DominikRzecki/mpm-hardware/README.md

# mpm-hardware
Mobile power measurement. Hardware repo
Update
