DominikRzecki/mpm-hardware/breakout-board-power-measurement/component-list.txt

Shunts 11x:
Einer davon:
	https://www.mouser.at/c/passive-components/resistors/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
z.B:
	https://www.mouser.at/ProductDetail/SEI-Stackpole/CSNL1206FT10L0?qs=IPgv5n7u5QaI49TqMum75g%3D%3D
	
oder:
	https://www.distrelec.at/de/shunt-10mohm-metallschicht-1w-ohmite-fc4l32r010fer/p/30229675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
oder:
	https://at.rs-online.com/web/p/smd-widerstande/1260359
	
Spulen: 11x
	https://at.rs-online.com/web/p/smd-induktivitat/1675875
oder:
	https://at.rs-online.com/web/p/smd-induktivitat/7474751
	
Oszillator 2x:
	https://at.rs-online.com/web/p/schwingquarz/6938803
	
Kondensator 5x:
	https://at.rs-online.com/web/p/keramik-vielschichtkondensatoren/1466584
