DominikRzecki/mpm-hardware/mechanik_3d/Files_for_print/deckel_main_v2.stl

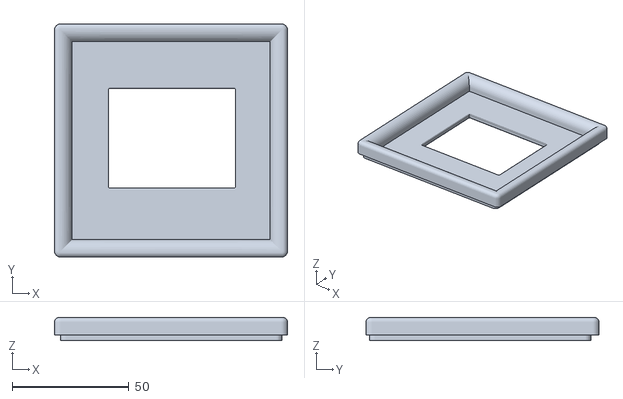
[picture p1: CAD file, 2023-05-02]
mechanik_3d/Files_for_print/deckel_main_v2.stl
100.0 x 100.0 x 10.00
