DominikRzecki/mpm-hardware/mechanik_3d/Files_for_print/main_box_v3.stl

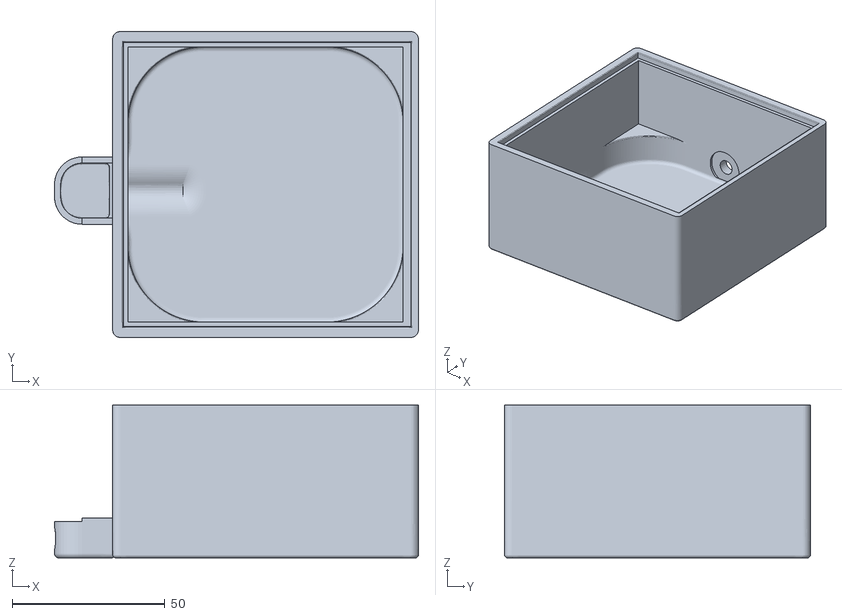
[picture p2: CAD file, 2023-05-02]
mechanik_3d/Files_for_print/main_box_v3.stl
119.0 x 100.0 x 50.0
