DominikRzecki/mpm-hardware/mechanik_3d/Files_for_print/deckel_v2.stl

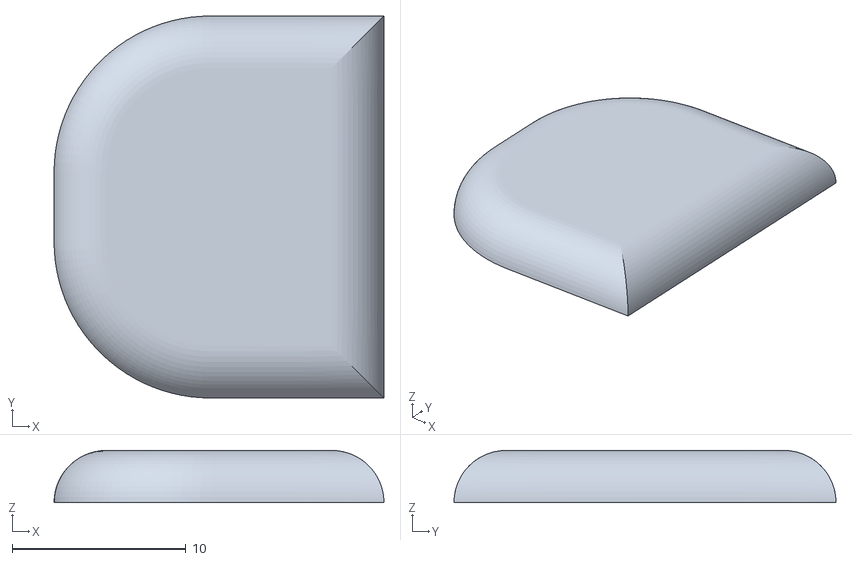
[picture p3: CAD file, 2023-05-02]
mechanik_3d/Files_for_print/deckel_v2.stl
19.0 x 22.0 x 3.00
