DominikRzecki/mpm-hardware/(list of files, cad)

Other CAD files:
mechanik_3d/Files_for_print/main_box_v2.stl
mechanik_3d/MPM_pwm v19.f3d
mechanik_3d/MPM_pwm v7.f3d
