DominikRzecki/mpm-hardware/breakout-board-power-measurement/power_measurement_fraesen/project/breakout-board-power-measurement.pdf

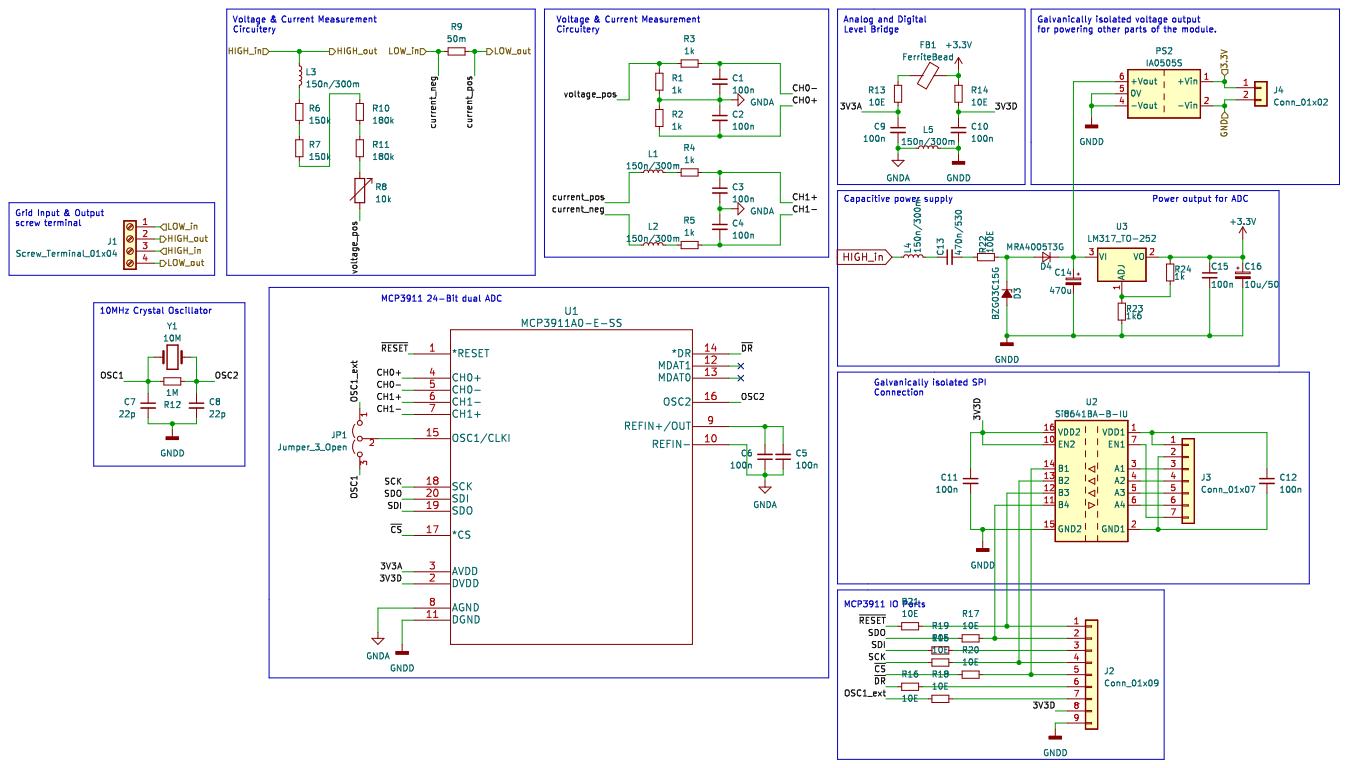
[picture p4: page 1]
