DominikRzecki/mpm-hardware/breakout-board-power-measurement/ltspice/capacitive-power-supply-3.asc

C1: cap; 25µ
C2: cap; 470µ
C3: cap; 10n
C4: cap; 100n
C5: cap; 470µ
D1: zener; 1N4469
D2: schottky; UPSC600
D4: diode
D5: diode
D6: diode
D7: diode
L1: ind; 10µH
R1: res; 100
R2: res; 1k6
R3: res; 1k
R4: res; 3
U1: LM317
V1: voltage; SINE(0 {230*sqrt(2)} 50)
Named nets: 0, ue, ua, ux
.tran 0 30ms 0 .001 uic
Am LM317 fällt sehr viel Leistung ab
 -> Buck könnte besser
