DominikRzecki/mpm-hardware/breakout-board-power-measurement/ltspice/capacitive-power-supply-2.asc

C1: cap; 820n
C2: cap; 470µ
C3: cap; 10n
C4: cap; 100n
C5: cap; 470µ
D1: zener; BZX84C15L
D2: schottky; UPSC600
R1: res; 100
R2: res; 1k6
R3: res; 1k
R4: res; 165
U1: LM317
V1: voltage; SINE(0 {230*sqrt(2)} 50)
Named nets: 0, ue, ua, ux
.tran 0 2 1.92 .001 uic
Am LM317 fällt sehr viel Leistung ab
 -> Buck könnte besser
