DominikRzecki/mpm-hardware/breakout-board-power-measurement/ltspice/Draft2.asc

C1: cap; 100n
L1: FerriteBead; 3.42µ; Ipk=0.2 Rser=0.6 Rpar=2780 Cpar=970f mfg="Würth Elektronik" pn="742792093 WE-CBF 0805"
R1: res; 165
V1: voltage; 3.3
V2: voltage; PULSE(0 .001 0 10n 10n 50n 100n)
Named nets: 0
.tran 0 .5 0 .000001
