DominikRzecki/mpm-hardware/breakout-board-power-measurement/ltspice/capacitive-power-supply.asc

C1: cap; 470µ
C2: cap; 820µ
C3: cap; 10n
C4: cap; 100n
C5: cap; 470µ
C6: cap; 470µ
C7: cap; 820µ
C8: cap; 10n
C9: cap; 100n
C10: cap; 470µ
C11: cap; 10nF
C12: cap; 22µF
C13: cap; 0.1µF
C14: cap; 10pF
C15: cap; 1µF
D1: zener; 1N4471
D2: schottky; UPSC600
D3: zener; 1N4471
D4: schottky; UPSC600
L1: ind; 2.2µH
R1: res; 100
R2: res; 1k6
R3: res; 1k
R5: res; 100
R6: res; 4.7
R7: res; 309k
R8: res; 1Meg
R9: res; 18.2k
R10: res; 100k
Rl: res; 4.7
U1: LM317
U2: LT8607
V1: voltage; SINE(0 {230*sqrt(2)} 50)
V2: voltage; SINE(0 {230*sqrt(2)} 50)
Named nets: 0, ue, ua, ux, ue1, ux1, ua1
.tran 0 40 0 1 uic
Am LM317 fällt sehr viel Leistung ab
 -> Buck könnte besser
Mit Buck
