DominikRzecki/mpm-hardware/power-measurement-final/power-measurement-final/power-measurement-final.kicad_pcb

## KiCad design power-measurement-final/power-measurement-final/power-measurement-final.kicad_pcb (2023-05-12)

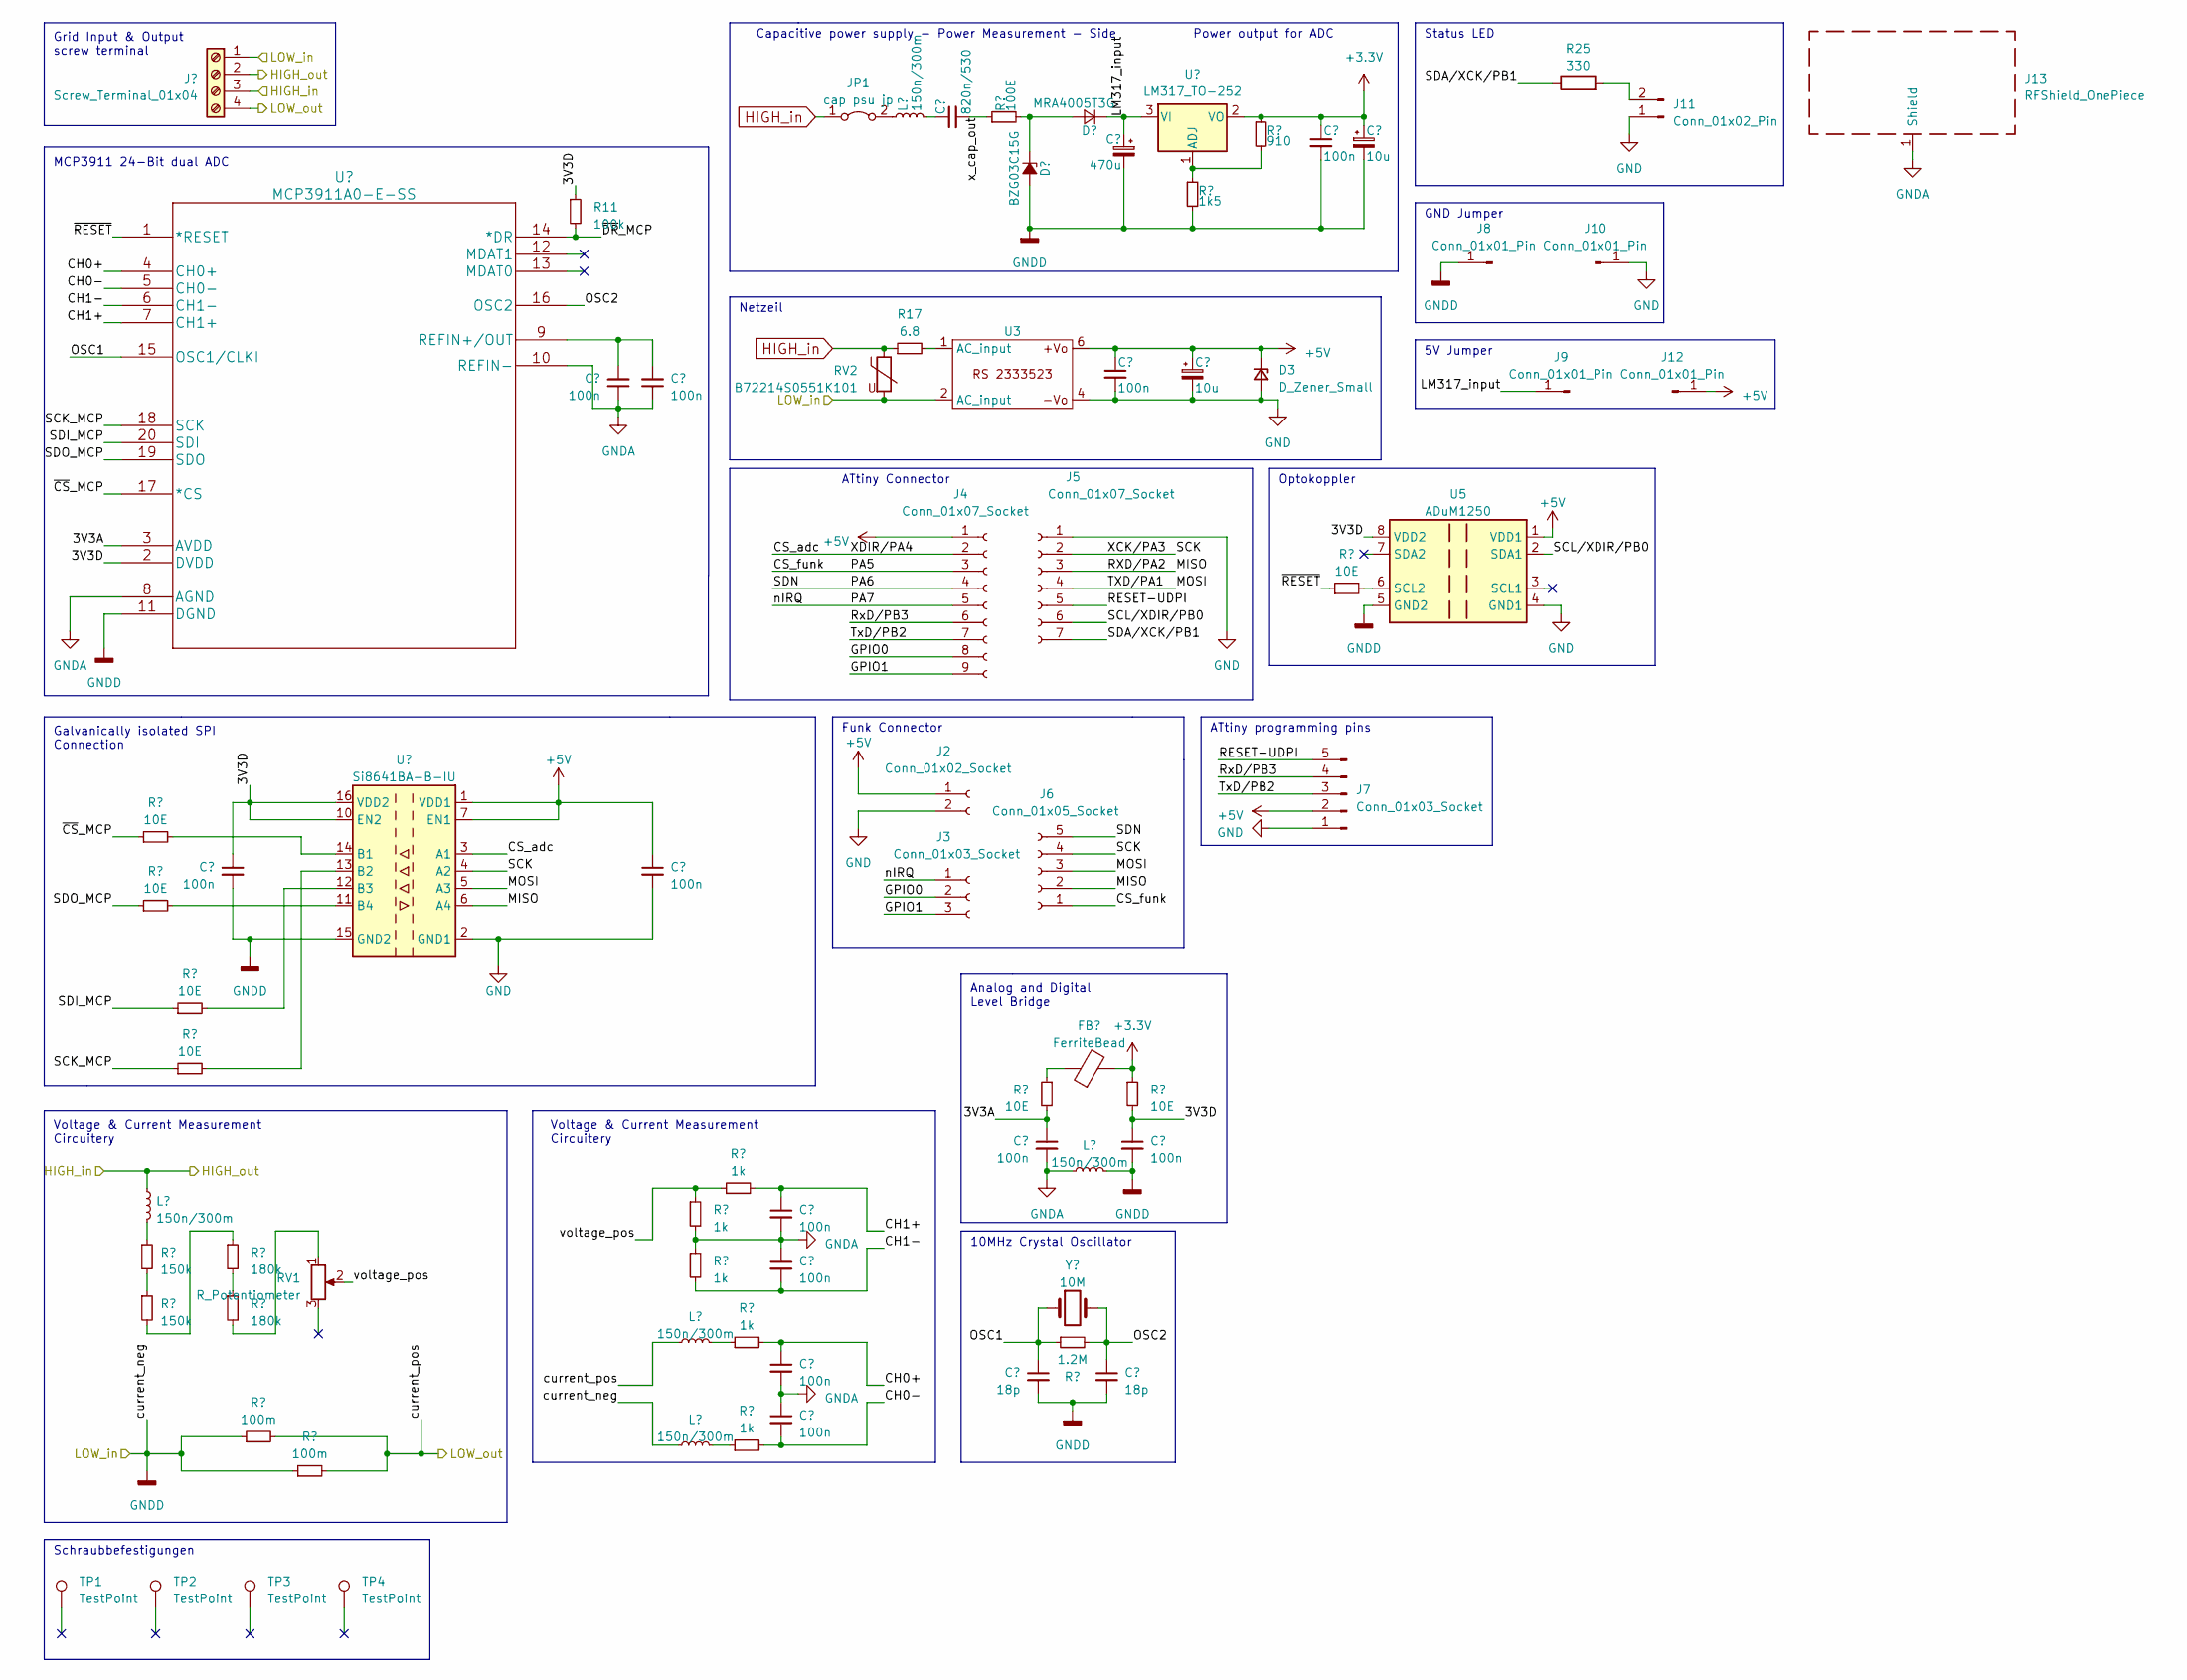
[picture p5: schematic power-measurement-final.kicad_sch]

Parts:
C1, C2, C3, C4, C5, C6, C7, C8, C11, C13, C15, C17: 100n; C_1206_3216Metric_Pad1.33x1.80mm_HandSolder
C9: 820n/530; C_Rect_L26.5mm_W10.5mm_P22.50mm_MKS4
C10, C12: 18p; C_0805_2012Metric_Pad1.18x1.45mm_HandSolder
C14: 470u; CP_Radial_D10.0mm_P5.00mm
C16, C18: 10u; C_1206_3216Metric_Pad1.33x1.80mm_HandSolder
D1: BZG03C15G; D_SMA-SMB_Universal_Handsoldering
D2: MRA4005T3G; D_MicroMELF_Handsoldering
D3: D_Zener_Small; D_1206_3216Metric_Pad1.42x1.75mm_HandSolder
FB1: FerriteBead; L_1210_3225Metric_Pad1.42x2.65mm_HandSolder
J1: Screw_Terminal_01x04; PhoenixContact_MSTBVA_2,5_4-G-5,08_1x04_P5.08mm_Vertical
J2: Conn_01x02_Socket; PinSocket_1x02_P2.54mm_Vertical
J3: Conn_01x03_Socket; PinSocket_1x03_P2.54mm_Vertical
J4: Conn_01x07_Socket; PinSocket_1x09_P2.54mm_Vertical
J5: Conn_01x07_Socket; PinSocket_1x07_P2.54mm_Vertical
J6: Conn_01x05_Socket; PinSocket_1x05_P2.54mm_Vertical
J7: Conn_01x03_Socket; PinHeader_1x05_P2.54mm_Vertical
J8, J9, J10, J12: Conn_01x01_Pin; PinHeader_1x01_P2.54mm_Vertical
J11: Conn_01x02_Pin; PinHeader_1x02_P2.54mm_Vertical
J13: RFShield_OnePiece; Laird_Technologies_BMI-S-209-F_29.36x18.50mm
JP1: cap psu jp; PinHeader_1x02_P2.54mm_Vertical
L1, L2, L3, L4, L5: 150n/300m; L_1206_3216Metric
R1, R2: 150k; R_1206_3216Metric_Pad1.30x1.75mm_HandSolder
R3, R4, R5, R6, R19, R21, R24: 10E; R_0805_2012Metric_Pad1.20x1.40mm_HandSolder
R7, R8: 180k; R_1206_3216Metric_Pad1.30x1.75mm_HandSolder
R9, R10: 100m; R_2512_6332Metric
R11: 100k; R_1206_3216Metric
R12, R13, R14, R15, R16: 1k; R_1206_3216Metric_Pad1.30x1.75mm_HandSolder
R17: 6.8; R_Radial_Power_L12.0mm_W8.0mm_P5.00mm
R18: 100E; R_1206_3216Metric_Pad1.30x1.75mm_HandSolder
R20: 1.2M; R_1206_3216Metric_Pad1.30x1.75mm_HandSolder
R22: 1k5; R_1206_3216Metric_Pad1.30x1.75mm_HandSolder
R23: 910; R_1206_3216Metric_Pad1.30x1.75mm_HandSolder
R25: 330; R_1206_3216Metric_Pad1.30x1.75mm_HandSolder
RV1: R_Potentiometer; Potentiometer_ACP_CA9-V10_Vertical_Hole
RV2: B72214S0551K101; R_Axial_DIN0204_L3.6mm_D1.6mm_P7.62mm_Horizontal
TP1, TP2, TP3, TP4: TestPoint; TestPoint_Plated_Hole_D3.0mm
U1: MCP3911A0-E-SS; SSOP-20_5.3x7.2mm_P0.65mm
U2: Si8641BA-B-IU; SOIC-16_3.9x9.9mm_P1.27mm
U3: RS_2333523
U4: LM317_TO-252; TO-252-2
U5: ADuM1250; SO-8_5.3x6.2mm_P1.27mm
Y1: 10M; Crystal_HC49-4H_Vertical

Connections:
+3.3V: C17.1, C18.1, FB1.2, R21.1, R23.1, U4.2 (VO)
+5V: C4.1, C13.1, C16.1, D3.1 (K), J2.1, J4.1, J7.2, J12.1, U2.1 (VDD1), U2.7 (EN1), U3.6, U5.1 (VDD1)
/3V3A: C11.1, R19.2, U1.3 (AVDD)
/3V3D: C1.1, C15.1, R11.1, R21.2, U1.2 (DVDD), U2.10 (EN2), U2.16 (VDD2), U5.8 (VDD2)
/CH0+: C7.1, R15.2, U1.4 (CH0+)
/CH0-: C8.2, R16.2, U1.5 (CH0-)
/CH1+: C5.1, R14.2, U1.7 (CH1+)
/CH1-: C6.2, R13.2, U1.6 (CH1-)
/CS_adc: J4.2, U2.3 (A1)
/CS_funk: J4.3, J6.1
/GPIO0: J3.2, J4.8
/GPIO1: J3.3, J4.9
/LM317_input: C14.1, D2.1 (K), J9.1, U4.3 (VI)
/MISO: J5.3, J6.2, U2.6 (A4)
/MOSI: J5.4, J6.3, U2.5 (A3)
/OSC1: C10.1, R20.1, U1.15 (OSC1/CLKI), Y1.1
/OSC2: C12.1, R20.2, U1.16 (OSC2), Y1.2
/PA6: J4.4, J6.5
/PA7: J3.1, J4.5
/RESET-UDPI: J5.5, J7.5
/RxD/PB3: J4.6, J7.4
/SCK: J5.2, J6.4, U2.4 (A2)
/SCK_MCP: R6.1, U1.18 (SCK)
/SCL/XDIR/PB0: J5.6, U5.2 (SDA1)
/SDA/XCK/PB1: J5.7, R25.1
/SDI_MCP: R5.1, U1.20 (SDI)
/SDO_MCP: R4.1, U1.19 (SDO)
/TxD/PB2: J4.7, J7.3
/current_pos: J1.4, L2.1, R9.2, R10.2
/voltage_pos: R12.1, R14.1, RV1.2
/x_cap_out: C9.2, R18.1
/~CS_MCP: R3.1, U1.17 (*CS)
/~DR_MCP: R11.2, U1.14 (*DR)
/~RESET: R24.1, U1.1 (*RESET)
GND: C4.2, C13.2, C16.2, D3.2 (A), J2.2, J5.1, J7.1, J10.1, J11.1, U2.2 (GND1), U2.8 (GND1), U3.4, U5.4 (GND1)
GNDA: C2.1, C3.1, C5.2, C6.1, C7.2, C8.1, C11.2, J13.1 (Shield), L5.1, R12.2, R13.1, U1.8 (AGND), U1.10 (REFIN-)
GNDD: C1.2, C10.2, C12.2, C14.2, C15.2, C17.2, C18.2, D1.2 (A), J1.1, J8.1, L3.1, L5.2, R9.1, R10.1, R22.2, RV2.2, U1.11 (DGND), U2.9 (GND2), U2.15 (GND2), U3.2 (AC_input), U5.5 (GND2)
HIGH_in: J1.2, J1.3, JP1.1 (A), L1.1, R17.1, RV2.1
unnamed: C9.1, L4.2
unnamed: D1.1 (K), D2.2 (A), R18.2
unnamed: FB1.1, R19.1
unnamed: J11.2, R25.2
unnamed: JP1.2 (B), L4.1
unnamed: L1.2, R1.1
unnamed: L2.2, R15.1
unnamed: L3.2, R16.1
unnamed: R1.2, R2.1
unnamed: R2.2, R7.1
unnamed: R7.2, R8.1
unnamed: R8.2, RV1.1
unnamed: R17.2, U3.1 (AC_input)
unnamed: C2.2, C3.2, U1.9 (REFIN+/OUT)
unnamed: R3.2, U2.14 (B1)
unnamed: R6.2, U2.13 (B2)
unnamed: R5.2, U2.12 (B3)
unnamed: R4.2, U2.11 (B4)
unnamed: R22.1, R23.2, U4.1 (ADJ)
unnamed: R24.2, U5.6 (SCL2)

Notes on the sheet:
Netzeil
Voltage & Current Measurement Circuitery
10MHz Crystal Oscillator
Funk Connector
Status LED
ATtiny Connector
Optokoppler
MCP3911 24-Bit dual ADC
5V Jumper
Capacitive power supply - Power Measurement - Side
Power output for ADC
ATtiny programming pins
Schraubbefestigungen
GND Jumper
Galvanically isolated SPI Connection
Grid Input & Output screw terminal
Analog and Digital Level Bridge

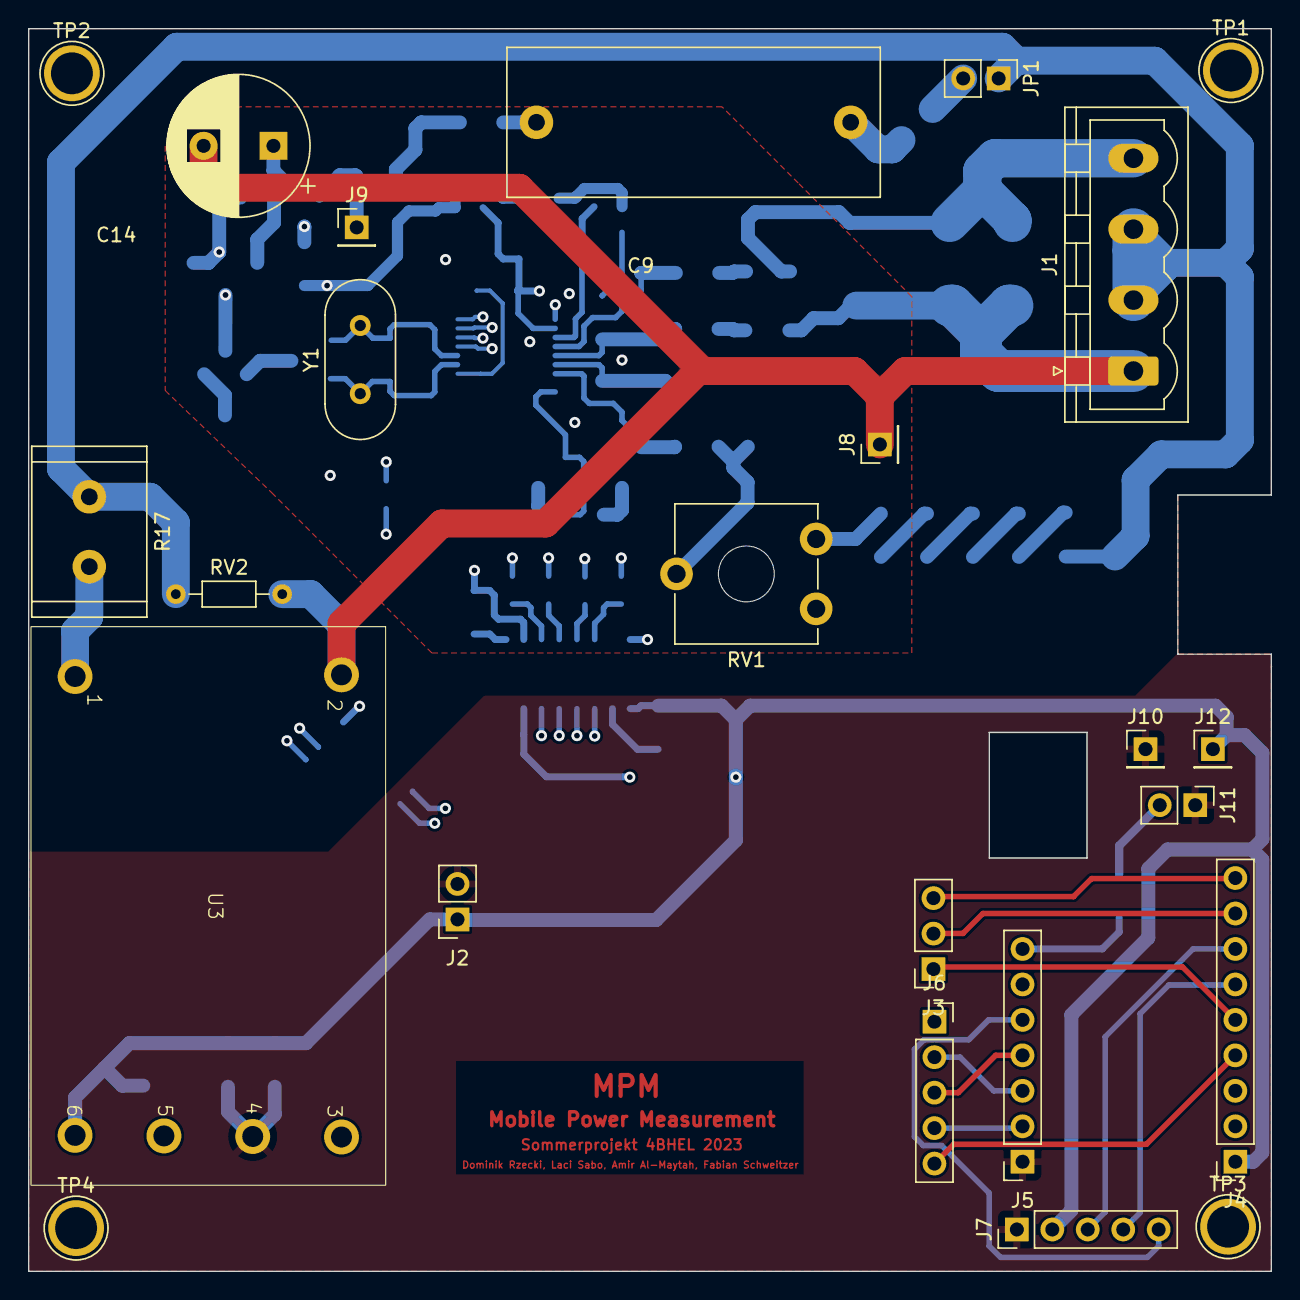
[picture p6: board power-measurement-final.kicad_pcb from above]

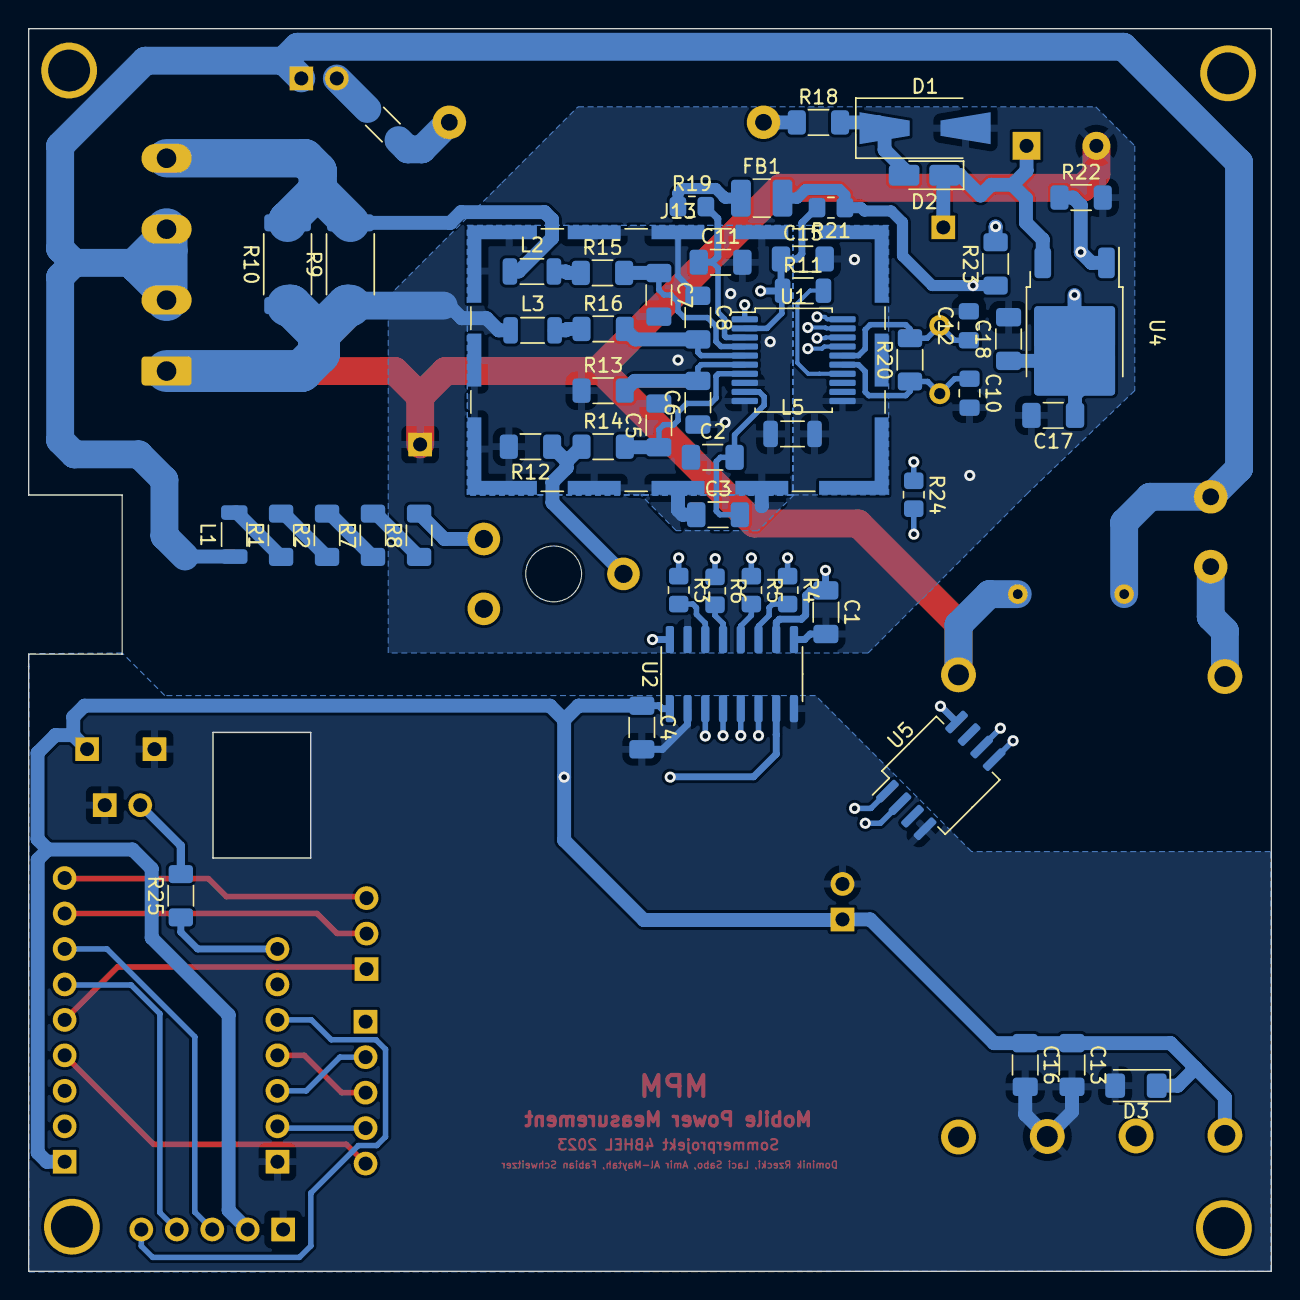
[picture p7: board power-measurement-final.kicad_pcb from below]

Board: 4 copper layers, 89.0 x 89.0 mm, 78 parts (54 on the bottom side), 58 nets.
