DominikRzecki/mpm-hardware/breakout-power-supply/breakout-power-supply.kicad_pcb

## KiCad design breakout-power-supply/breakout-power-supply.kicad_pcb (2023-05-08)

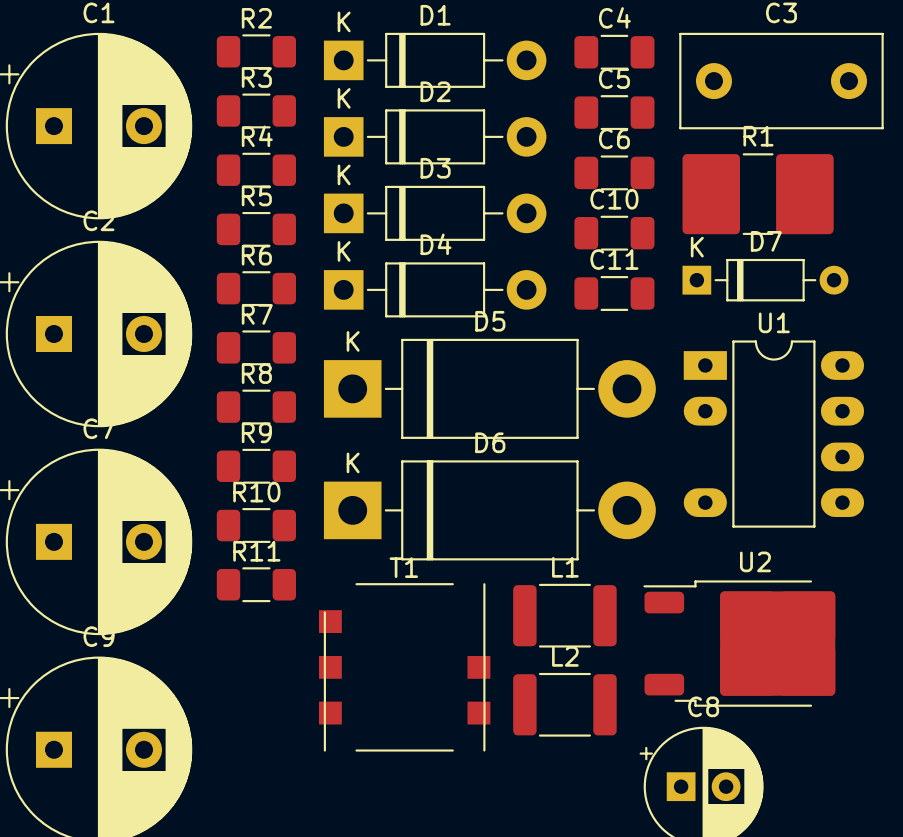
[picture p8: board breakout-power-supply.kicad_pcb from above]

Board: 2 copper layers, 34 parts (0 on the bottom side), 20 nets, no tracks yet.

Parts:
C1, C2: 6u8; CP_Radial_D10.0mm_P5.00mm
C3: 1n; C_Disc_D11.0mm_W5.0mm_P7.50mm
C4, C5, C6: 1u; C_1206_3216Metric_Pad1.33x1.80mm_HandSolder
C7: 1000u; CP_Radial_D10.0mm_P5.00mm
C8: 470u; CP_Radial_D6.3mm_P2.50mm
C9: 470u; CP_Radial_D10.0mm_P5.00mm
C10: 100n; C_1206_3216Metric_Pad1.33x1.80mm_HandSolder
C11: 10u; C_1206_3216Metric_Pad1.33x1.80mm_HandSolder
D1, D2, D3, D4: 1N4007; D_DO-41_SOD81_P10.16mm_Horizontal
D5: D; D_DO-201AD_P15.24mm_Horizontal
D6: 1N5822; D_DO-201AD_P15.24mm_Horizontal
D7: 1N4148; D_DO-35_SOD27_P7.62mm_Horizontal
L1, L2: 1m; L_1812_4532Metric_Pad1.30x3.40mm_HandSolder
R1: 10E; R_2816_7142Metric_Pad3.20x4.45mm_HandSolder
R2: 270k; R_1206_3216Metric_Pad1.30x1.75mm_HandSolder
R3: 330E; R_1206_3216Metric_Pad1.30x1.75mm_HandSolder
R4, R8: 28.7k; R_1206_3216Metric_Pad1.30x1.75mm_HandSolder
R5: 4.42k; R_1206_3216Metric_Pad1.30x1.75mm_HandSolder
R6, R7: 12E; R_1206_3216Metric_Pad1.30x1.75mm_HandSolder
R9: 820E; R_1206_3216Metric_Pad1.30x1.75mm_HandSolder
R10: 1k5; R_1206_3216Metric_Pad1.30x1.75mm_HandSolder
R11: 910; R_1206_3216Metric_Pad1.30x1.75mm_HandSolder
T1: PA0510NL; Pulse_PA2002NL-PA2008NL-PA2009NL
U1: LNK625PG; PowerIntegrations_PDIP-8C
U2: LM317_TO-252; TO-252-2

Connections:
+3.3V: C10.1, C11.1, R11.1, U2.2 (VO)
/5V: C8.1, C9.1, L2.2, R9.2, U2.3 (VI)
/HIGH_in: D1.2 (A), D2.1 (K)
GND: C5.2, C7.2, C8.2, C9.2, C10.2, C11.2, D6.2 (A), R9.1, R10.2
unnamed: C2.2, C4.2, C6.2, L1.2, R5.1, T1.5, U1.5 (S), U1.6 (S), U1.7 (S), U1.8 (S)
unnamed: C3.2, R2.1, R3.2
unnamed: C5.1, R6.1
unnamed: C7.1, L2.1, T1.3
unnamed: C1.1, C2.1, C3.1, D1.1 (K), D3.1 (K), R2.2, T1.1
unnamed: C1.2, D2.2 (A), D4.2 (A), L1.1
unnamed: D3.2 (A), D4.1 (K), R1.2
unnamed: D5.2 (A), U1.4 (D)
unnamed: D5.1 (K), R3.1
unnamed: D6.1 (K), R6.2, T1.6
unnamed: D7.2 (A), R7.1
unnamed: C6.1, D7.1 (K), R8.2
unnamed: R4.2, R7.2, T1.4
unnamed: C4.1, R8.1, U1.2 (BP)
unnamed: R4.1, R5.2, U1.1 (FB)
unnamed: R10.1, R11.2, U2.1 (ADJ)
