DominikRzecki/mpm-hardware/funk-final/funk-transmitter-final/funk-transmitter-final.kicad_pcb

## KiCad design funk-final/funk-transmitter-final/funk-transmitter-final.kicad_pcb (2023-04-25)

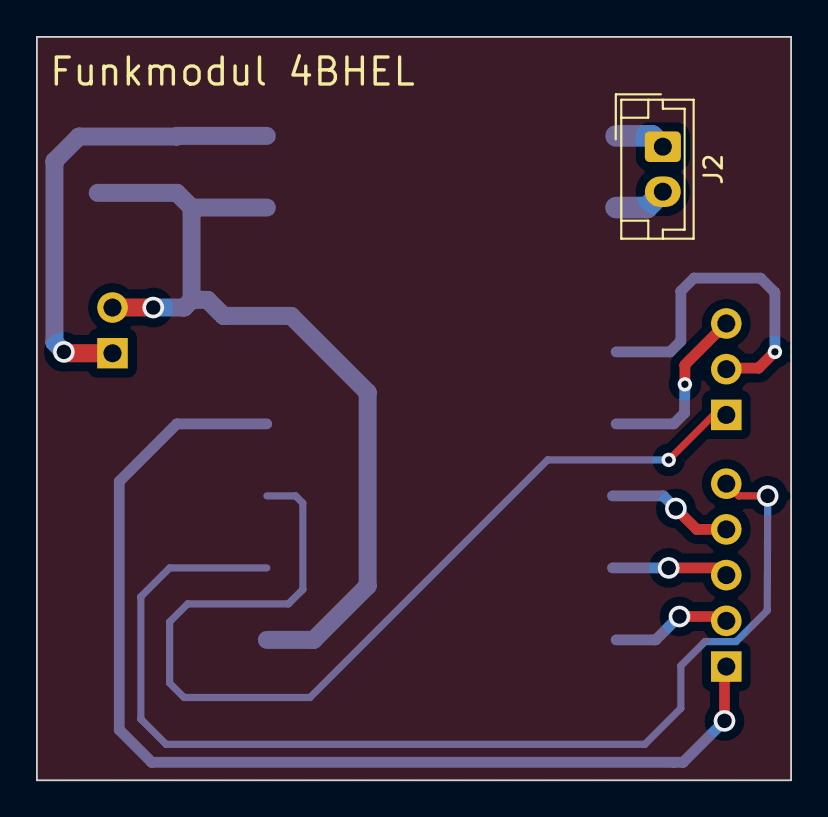
[picture p9: board funk-transmitter-final.kicad_pcb from above]

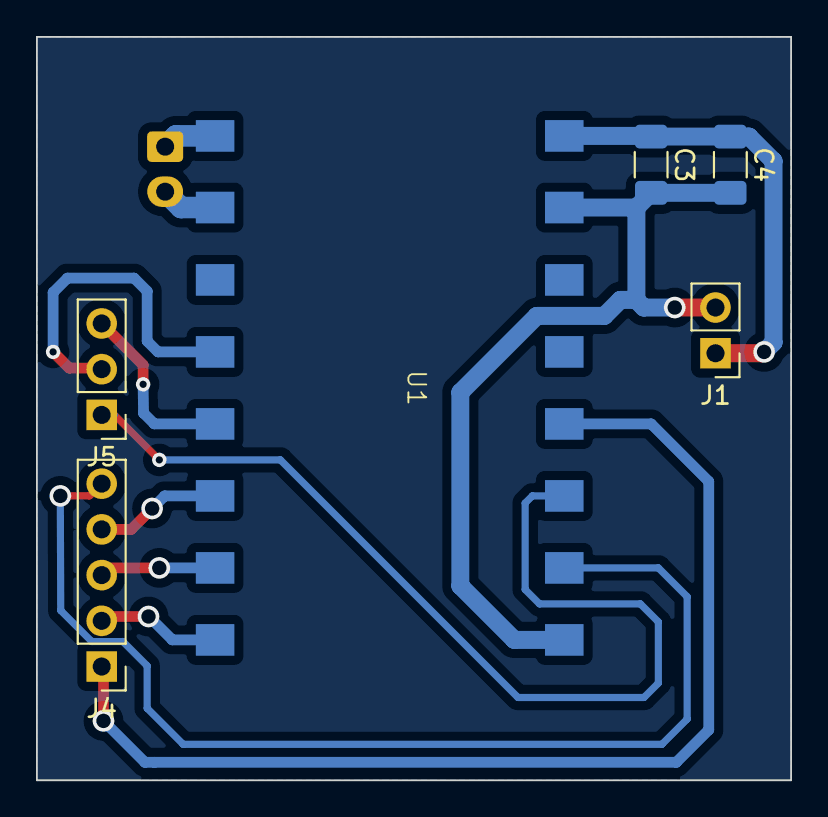
[picture p10: board funk-transmitter-final.kicad_pcb from below]

Board: 4 copper layers, 41.9 x 41.3 mm, 7 parts (6 on the bottom side), 9 nets.

Parts:
C3: 100n; C_1206_3216Metric_Pad1.33x1.80mm_HandSolder
C4: 47u; C_1206_3216Metric_Pad1.33x1.80mm_HandSolder
J1: Conn_01x02_Socket; PinHeader_1x02_P2.54mm_Vertical
J2: Conn_01x02_Socket; JST_EH_B2B-EH-A_1x02_P2.50mm_Vertical
J4: Conn_01x05_Socket; PinHeader_1x05_P2.54mm_Vertical
J5: Conn_01x03_Socket; PinHeader_1x03_P2.54mm_Vertical
U1: Si4463_eigen; Si4463

Connections:
/GPIO0: J5.2, U1.12 (GPIO0)
/GPIO1: J5.3, U1.13 (GPIO1)
/SCLK: J4.2, U1.16 (SCLK)
/SDI: J4.3, U1.15 (SDI)
/SDN: J4.1, U1.5 (SDN)
/SDO: J4.4, U1.14 (SDO)
/nIRQ: J5.1, U1.6 (nIRQ)
/nSEL: J4.5, U1.7 (nSEL)
GND: J1.2, U1.2 (GND), U1.8 (GND)
