DominikRzecki/mpm-hardware/display-brain-final/display-brain-final/display-brain-final.kicad_pcb

## KiCad design display-brain-final/display-brain-final/display-brain-final.kicad_pcb (2023-04-14)

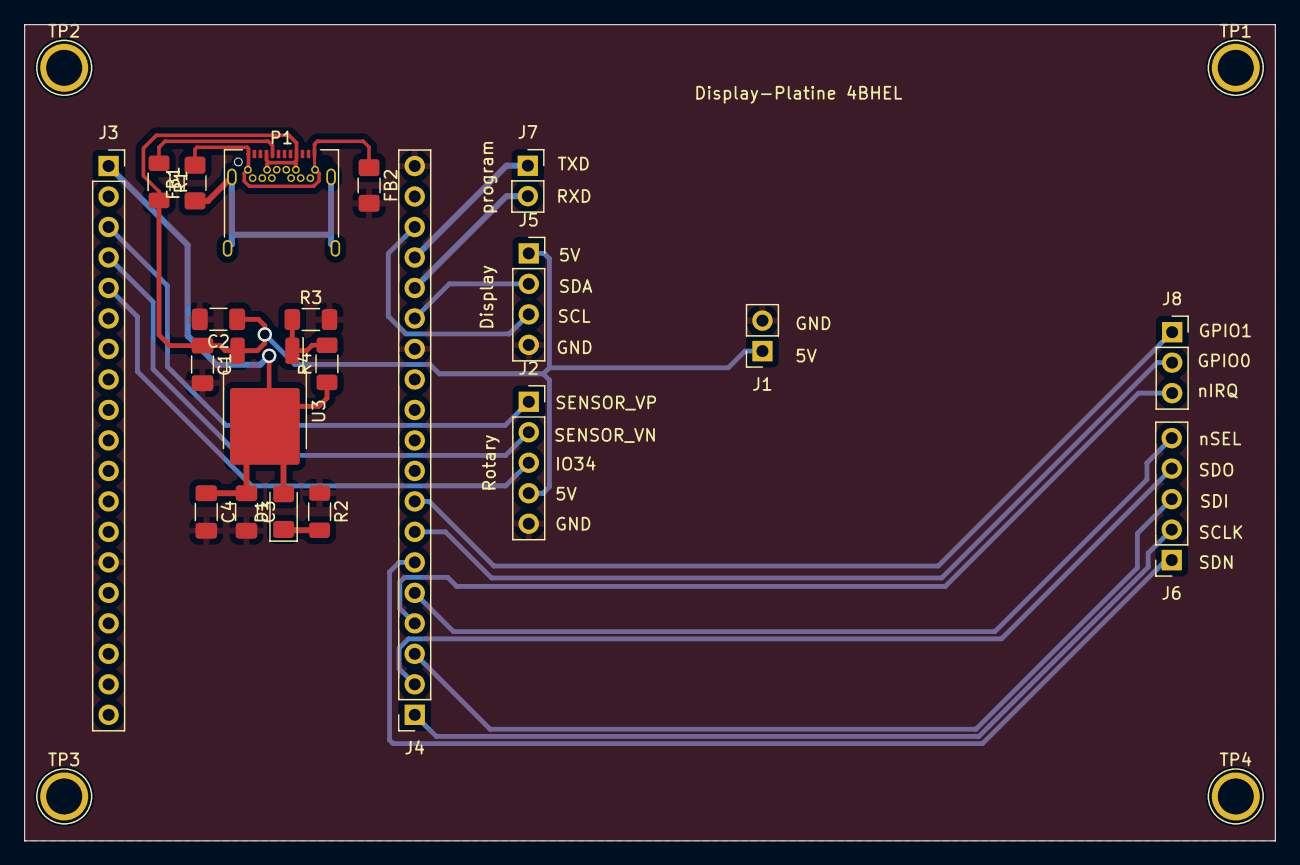
[picture p11: board display-brain-final.kicad_pcb from above]

Board: 4 copper layers, 104.2 x 68.0 mm, 25 parts (0 on the bottom side), 23 nets.

Parts:
C1, C4: 10u; C_1206_3216Metric_Pad1.33x1.80mm_HandSolder
C2, C3: 100n; C_1206_3216Metric_Pad1.33x1.80mm_HandSolder
D1: LED; D_1206_3216Metric_Pad1.42x1.75mm_HandSolder
FB1, FB2: FerriteBead_Small; L_1206_3216Metric_Pad1.42x1.75mm_HandSolder
J1, J7: Conn_01x02_Socket; PinSocket_1x02_P2.54mm_Vertical
J2, J6: Conn_01x05_Socket; PinSocket_1x05_P2.54mm_Vertical
J3, J4: Conn_01x19_Socket; PinSocket_1x19_P2.54mm_Vertical
J5: Conn_01x04_Socket; PinSocket_1x04_P2.54mm_Vertical
J8: Conn_01x03_Socket; PinSocket_1x03_P2.54mm_Vertical
P1: USB_C_Plug_USB2.0; USB_C_Receptacle_Amphenol_12401548E4-2A
R1: 56k; R_1206_3216Metric_Pad1.30x1.75mm_HandSolder
R2: 330; R_1206_3216Metric_Pad1.30x1.75mm_HandSolder
R3: 1k5; R_1206_3216Metric_Pad1.30x1.75mm_HandSolder
R4: 910; R_1206_3216Metric_Pad1.30x1.75mm_HandSolder
TP1, TP2, TP3, TP4: TestPoint; TestPoint_Plated_Hole_D3.0mm
U3: LM317_TO-252; TO-252-2

Connections:
/3V3: C3.1, C4.1, D1.2 (A), J3.1, R4.1, U3.2 (VO)
/5V: C1.1, C2.1, J1.1, J2.4, J5.1, P1.A4 (VBUS), P1.A9 (VBUS), P1.B4 (VBUS), P1.B9 (VBUS), R1.2, U3.3 (VI)
/CLK: J4.1, J6.2
/IO0: J4.6, J6.1
/IO2: J4.5, J6.5
/IO4: J4.7, J8.2
/IO15: J4.4, J8.3
/IO16: J4.8, J8.1
/IO21_SDA: J4.14, J5.2
/IO22_SCL: J4.17, J5.3
/IO34: J2.3, J3.5
/RXD0: J4.15, J7.2
/SD0: J4.2, J6.4
/SD1: J4.3, J6.3
/SENSOR_VN: J2.2, J3.4
/SENSOR_VP: J2.1, J3.3
/TXD0: J4.16, J7.1
GND: C1.2, C2.2, C3.2, C4.2, FB2.2, J1.2, J2.5, J3.14, J4.13, J4.19, J5.4, R2.1, R3.2
unnamed: D1.1 (K), R2.2
unnamed: FB1.2, FB2.1, P1.A1 (GND), P1.A12 (GND), P1.B1 (GND), P1.B12 (GND)
unnamed: P1.A5 (CC), R1.1
unnamed: FB1.1, P1.S1 (SHIELD)
unnamed: R3.1, R4.2, U3.1 (ADJ)
