DominikRzecki/mpm-hardware/ATtiny-final/ATtiny-final/ATtiny-final.kicad_pcb

## KiCad design ATtiny-final/ATtiny-final/ATtiny-final.kicad_pcb (2023-04-14)

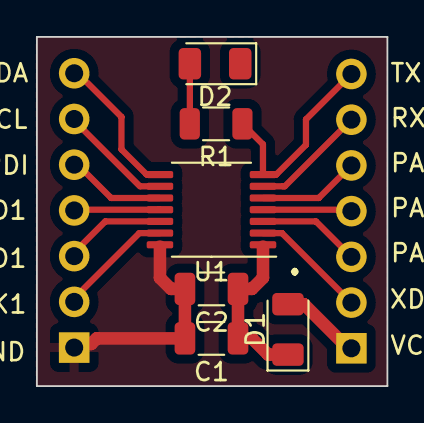
[picture p12: board ATtiny-final.kicad_pcb from above]

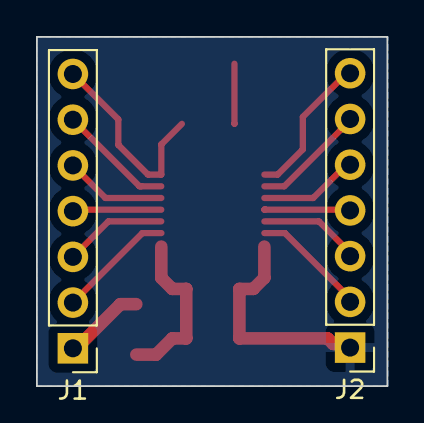
[picture p13: board ATtiny-final.kicad_pcb from below]

Board: 4 copper layers, 19.5 x 19.4 mm, 8 parts (2 on the bottom side), 2 nets.

Parts:
C1: 10n; C_1206_3216Metric
C2: 100n; C_1206_3216Metric
D1: D_Schottky; D_1206_3216Metric
D2: LED_Small; D_1206_3216Metric
J1, J2: Conn_01x07_Male; PinHeader_1x07_P2.54mm_Vertical
R1: 330; R_1206_3216Metric
U1: ATtiny424-X; TSSOP-14_4.4x5mm_P0.65mm

Connections:
/PA6: J1.4, U1.4 (PA6)
/XDIR/PA4: J1.2, U1.2 (PA4)
