DominikRzecki/mpm-hardware/breakout-board-power-measurement/breakout-board-power-measurement/breakout-board-power-measurement.kicad_pcb

## KiCad design breakout-board-power-measurement/breakout-board-power-measurement/breakout-board-power-measurement.kicad_pcb (2023-04-14)

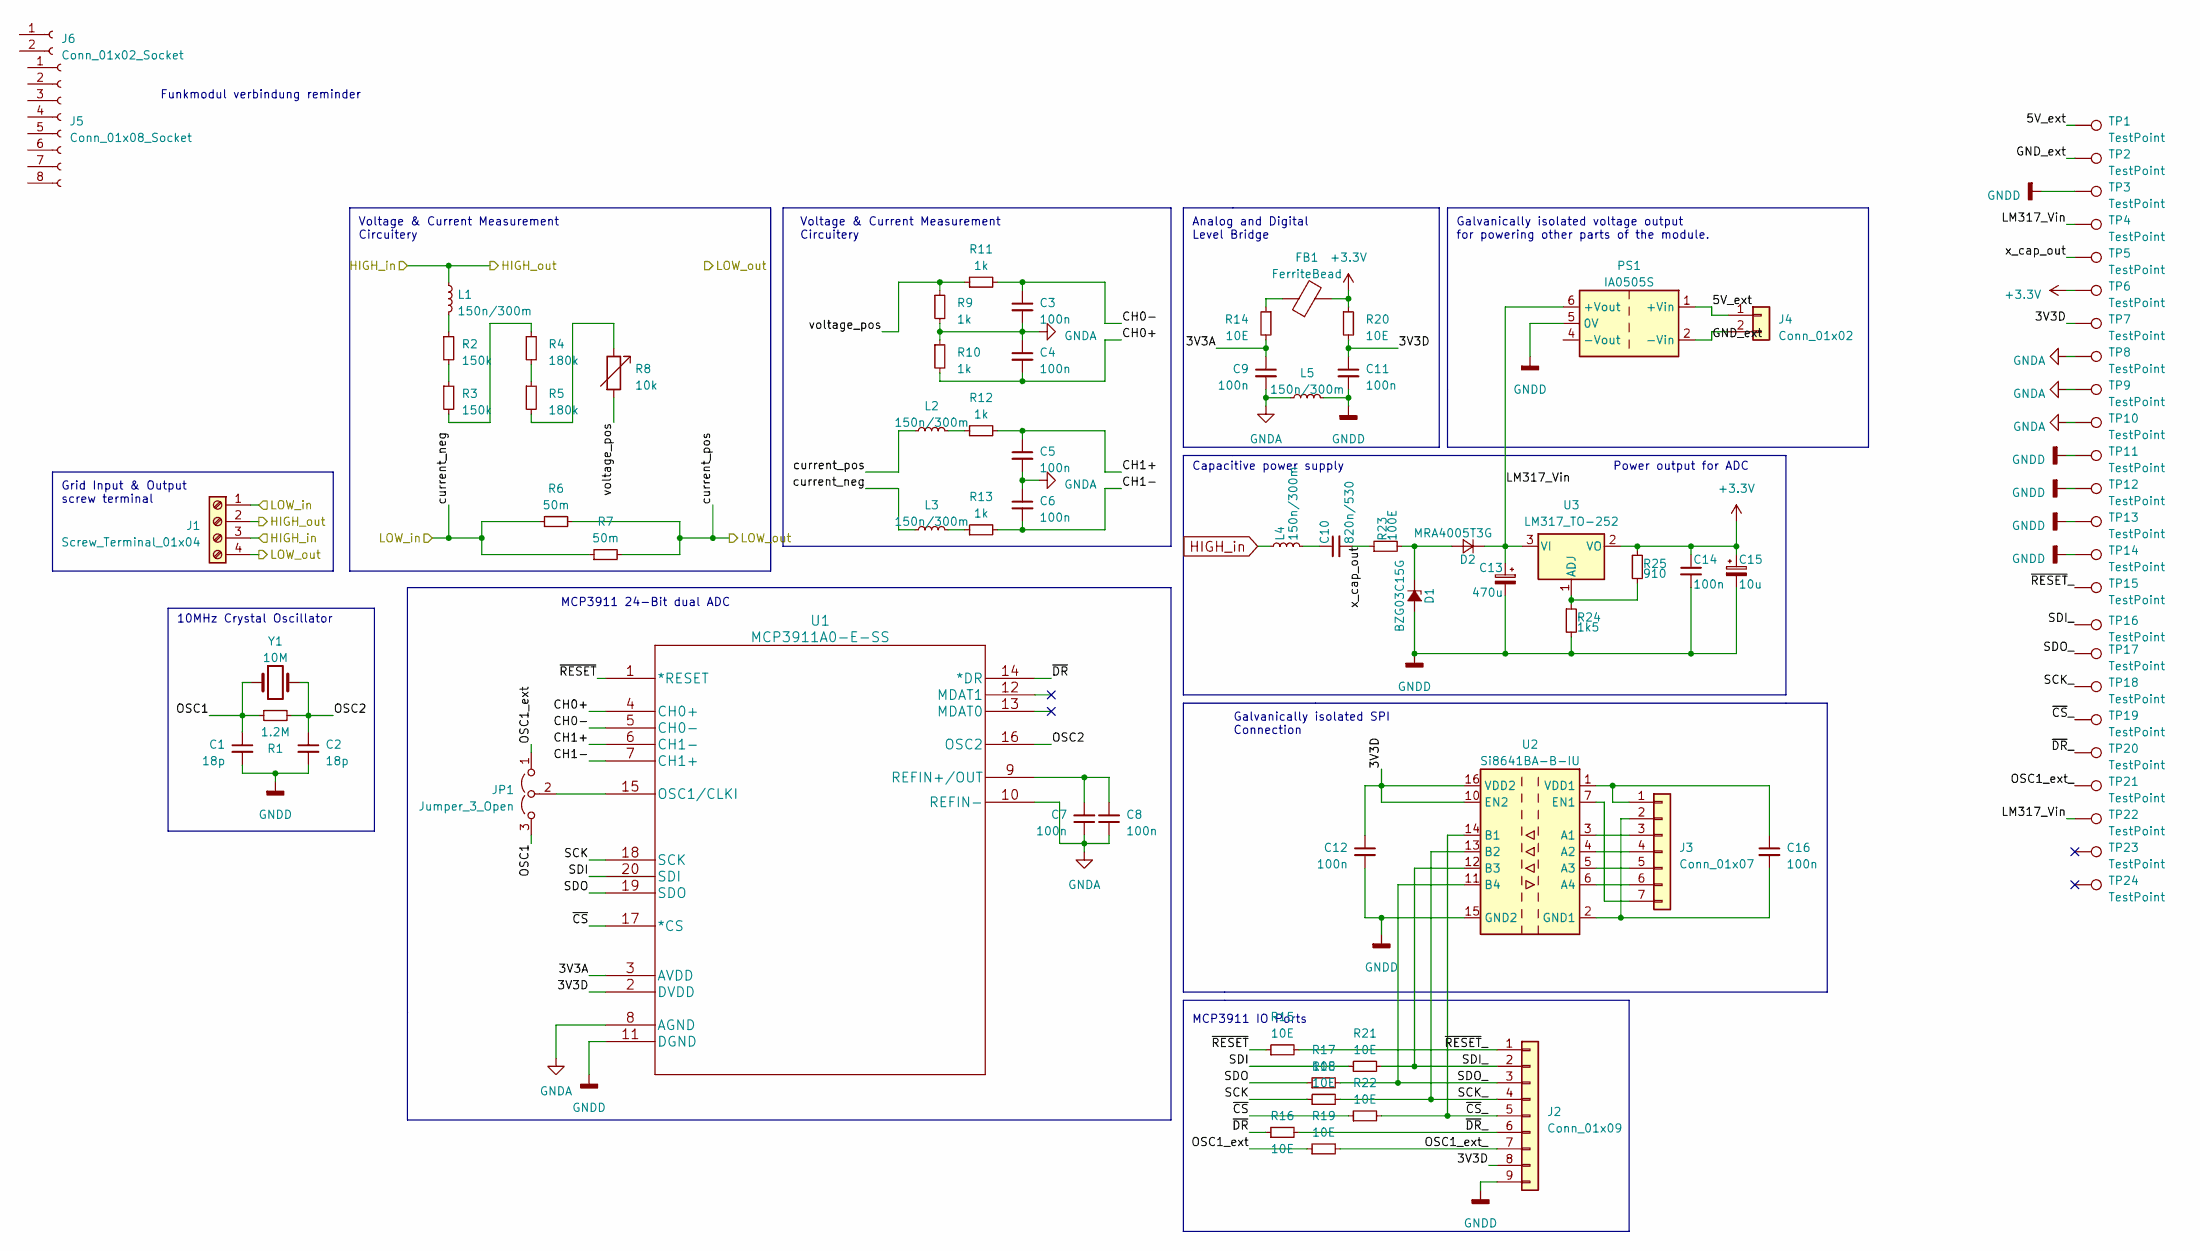
[picture p14: schematic breakout-board-power-measurement.kicad_sch]

Parts:
C1, C2: 18p; C_0805_2012Metric_Pad1.18x1.45mm_HandSolder
C3, C4, C5, C6, C7, C8, C9, C11, C12, C14, C16: 100n; C_1206_3216Metric_Pad1.33x1.80mm_HandSolder
C10: 820n/530; C_Rect_L26.5mm_W10.5mm_P22.50mm_MKS4
C13: 470u; CP_Radial_D10.0mm_P5.00mm
C15: 10u; C_1206_3216Metric_Pad1.33x1.80mm_HandSolder
D1: BZG03C15G; D_SMA-SMB_Universal_Handsoldering
D2: MRA4005T3G; D_MicroMELF_Handsoldering
FB1: FerriteBead; L_1210_3225Metric_Pad1.42x2.65mm_HandSolder
J1: Screw_Terminal_01x04; TerminalBlock_Altech_AK300-4_P5.00mm
J2: Conn_01x09; PinHeader_1x09_P2.54mm_Vertical
J3: Conn_01x07; PinHeader_1x07_P2.54mm_Vertical
J4: Conn_01x02; PinHeader_1x02_P2.54mm_Vertical
J5: Conn_01x08_Socket
J6: Conn_01x02_Socket
JP1: Jumper_3_Open; PinHeader_1x03_P2.54mm_Vertical
L1, L2, L3, L4, L5: 150n/300m; L_1206_3216Metric
PS1: IA0505S; Converter_DCDC_XP_POWER-IAxxxxS_THT
R1: 1.2M; R_1206_3216Metric_Pad1.30x1.75mm_HandSolder
R2, R3: 150k; R_1206_3216Metric_Pad1.30x1.75mm_HandSolder
R4, R5: 180k; R_1206_3216Metric_Pad1.30x1.75mm_HandSolder
R6, R7: 50m; R_2512_6332Metric
R8: 10k; Potentiometer_ACP_CA9-V10_Vertical_Hole
R9, R10, R11, R12, R13: 1k; R_1206_3216Metric_Pad1.30x1.75mm_HandSolder
R14, R15, R16, R17, R18, R19, R20, R21, R22: 10E; R_0805_2012Metric_Pad1.20x1.40mm_HandSolder
R23: 100E; R_1206_3216Metric_Pad1.30x1.75mm_HandSolder
R24: 1k5; R_1206_3216Metric_Pad1.30x1.75mm_HandSolder
R25: 910; R_1206_3216Metric_Pad1.30x1.75mm_HandSolder
TP1, TP2, TP3, TP4, TP5, TP6, TP7, TP8, TP9, TP10, TP11, TP12, TP13, TP14, TP15, TP16, TP17, TP18, TP19, TP20, TP21, TP22: TestPoint; Via_THTPad_D1.5mm_Drill0.8mm
TP23, TP24: TestPoint; Screwhole_THTPad_D3.0mm_Drill2.0mm
U1: MCP3911A0-E-SS; MCP3911A0-E&slash_SS
U2: Si8641BA-B-IU; SOIC-16_3.9x9.9mm_P1.27mm
U3: LM317_TO-252; TO-252-2
Y1: 10M; Crystal_HC49-4H_Vertical

Connections:
+3.3V: C14.1, C15.1, FB1.2, R20.1, R25.1, TP6.1, U3.2 (VO)
/3V3A: C9.1, R14.2, U1.3 (AVDD)
/3V3D: C11.1, C12.1, J2.8, R20.2, TP7.1, U1.2 (DVDD), U2.10 (EN2), U2.16 (VDD2)
/5V_ext: J4.1, PS1.1 (+Vin), TP1.1
/CH0+: C4.2, R10.2, U1.4 (CH0+)
/CH0-: C3.1, R11.2, U1.5 (CH0-)
/CH1+: C5.1, R12.2, U1.6 (CH1-)
/CH1-: C6.2, R13.2, U1.7 (CH1+)
/GND_ext: J4.2, PS1.2 (-Vin), TP2.1
/LM317_Vin: C13.1, D2.1 (K), PS1.6 (+Vout), TP4.1, TP22.1, U3.3 (VI)
/OSC1: C1.1, JP1.3 (B), R1.1, Y1.1
/OSC1_ext: JP1.1 (A), R19.1
/OSC1_ext_: J2.7, R19.2, TP21.1
/OSC2: C2.1, R1.2, U1.16 (OSC2), Y1.2
/SCK: R18.1, U1.18 (SCK)
/SCK_: J2.4, R18.2, TP18.1, U2.13 (B2)
/SDI: R21.1, U1.20 (SDI)
/SDI_: J2.2, R21.2, TP16.1, U2.12 (B3)
/SDO: R17.1, U1.19 (SDO)
/SDO_: J2.3, R17.2, TP17.1, U2.11 (B4)
/current_neg: J1.1, L3.1, R6.1, R7.1
/current_pos: J1.4, L2.1, R6.2, R7.2
/voltage_pos: R8.2, R9.1, R11.1
/x_cap_out: C10.2, R23.1, TP5.1
/~CS: R22.1, U1.17 (*CS)
/~CS_: J2.5, R22.2, TP19.1, U2.14 (B1)
/~DR: R16.1, U1.14 (*DR)
/~DR_: J2.6, R16.2, TP20.1
/~RESET: R15.1, U1.1 (*RESET)
/~RESET_: J2.1, R15.2, TP15.1
GNDA: C3.2, C4.1, C5.2, C6.1, C7.1, C8.1, C9.2, L5.1, R9.2, R10.1, TP8.1, TP9.1, TP10.1, U1.8 (AGND), U1.10 (REFIN-)
GNDD: C1.2, C2.2, C11.2, C12.2, C13.2, C14.2, C15.2, D1.2 (A), J2.9, L5.2, PS1.5 (0V), R24.2, TP3.1, TP11.1, TP12.1, TP13.1, TP14.1, U1.11 (DGND), U2.9 (GND2), U2.15 (GND2)
HIGH_in: J1.2, J1.3, L1.1, L4.1
unnamed: C10.1, L4.2
unnamed: D1.1 (K), D2.2 (A), R23.2
unnamed: FB1.1, R14.1
unnamed: C16.1, J3.1, U2.1 (VDD1)
unnamed: C16.2, J3.2, U2.2 (GND1), U2.8 (GND1)
unnamed: J3.3, U2.3 (A1)
unnamed: J3.4, U2.4 (A2)
unnamed: J3.5, U2.5 (A3)
unnamed: J3.6, U2.6 (A4)
unnamed: J3.7, U2.7 (EN1)
unnamed: JP1.2 (C), U1.15 (OSC1/CLKI)
unnamed: L1.2, R2.1
unnamed: L2.2, R12.1
unnamed: L3.2, R13.1
unnamed: R2.2, R3.1
unnamed: R3.2, R4.1
unnamed: R4.2, R5.1
unnamed: R5.2, R8.1
unnamed: C7.2, C8.2, U1.9 (REFIN+/OUT)
unnamed: R24.1, R25.2, U3.1 (ADJ)

Notes on the sheet:
Grid Input & Output screw terminal
Power output for ADC
Capacitive power supply
MCP3911 IO Ports
Analog and Digital Level Bridge
MCP3911 24-Bit dual ADC
10MHz Crystal Oscillator
Galvanically isolated voltage output for powering other parts of the module.
Voltage & Current Measurement Circuitery
Funkmodul verbindung reminder
Galvanically isolated SPI Connection
