DominikRzecki/mpm-hardware/breakout-board-power-measurement/breakout-board-power-measurement/breakout-board-power-measurement.kicad_pcb

## KiCad design breakout-board-power-measurement/breakout-board-power-measurement/breakout-board-power-measurement.kicad_pcb (continued)

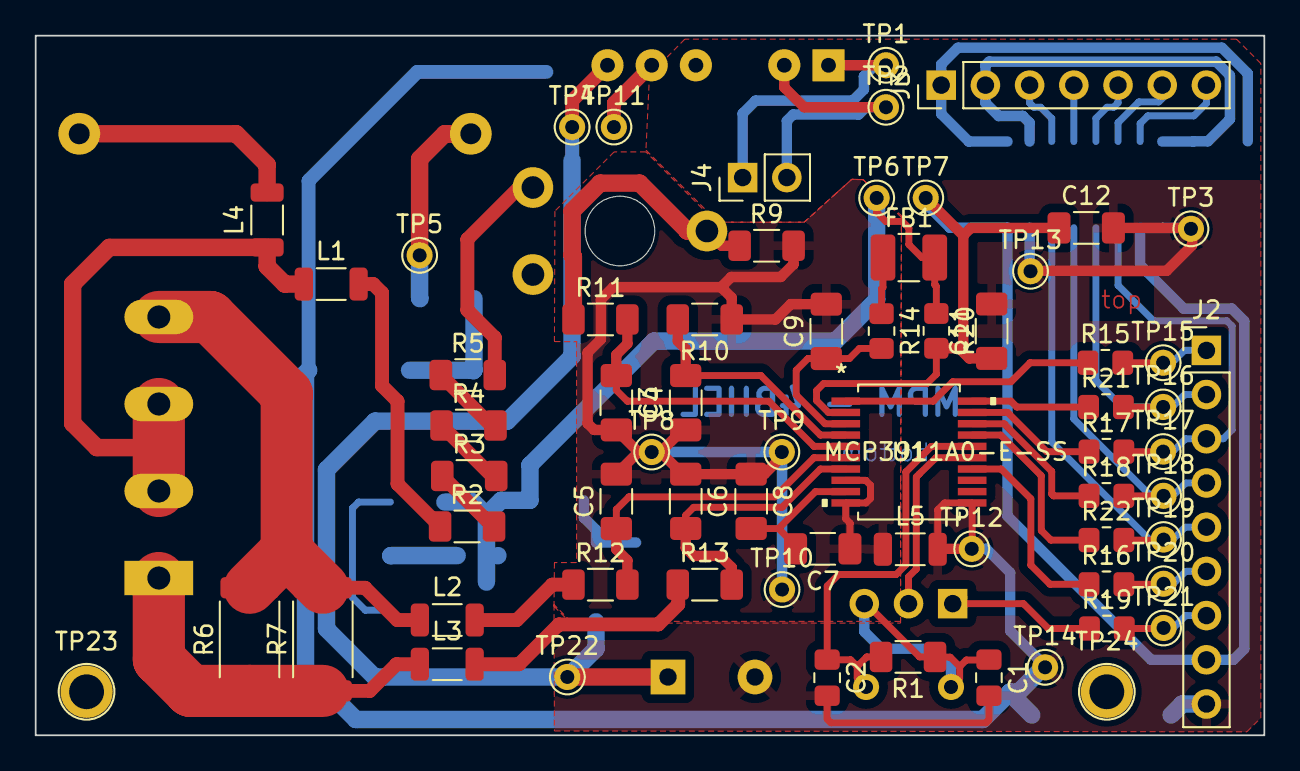
[picture p15: board breakout-board-power-measurement.kicad_pcb from above]

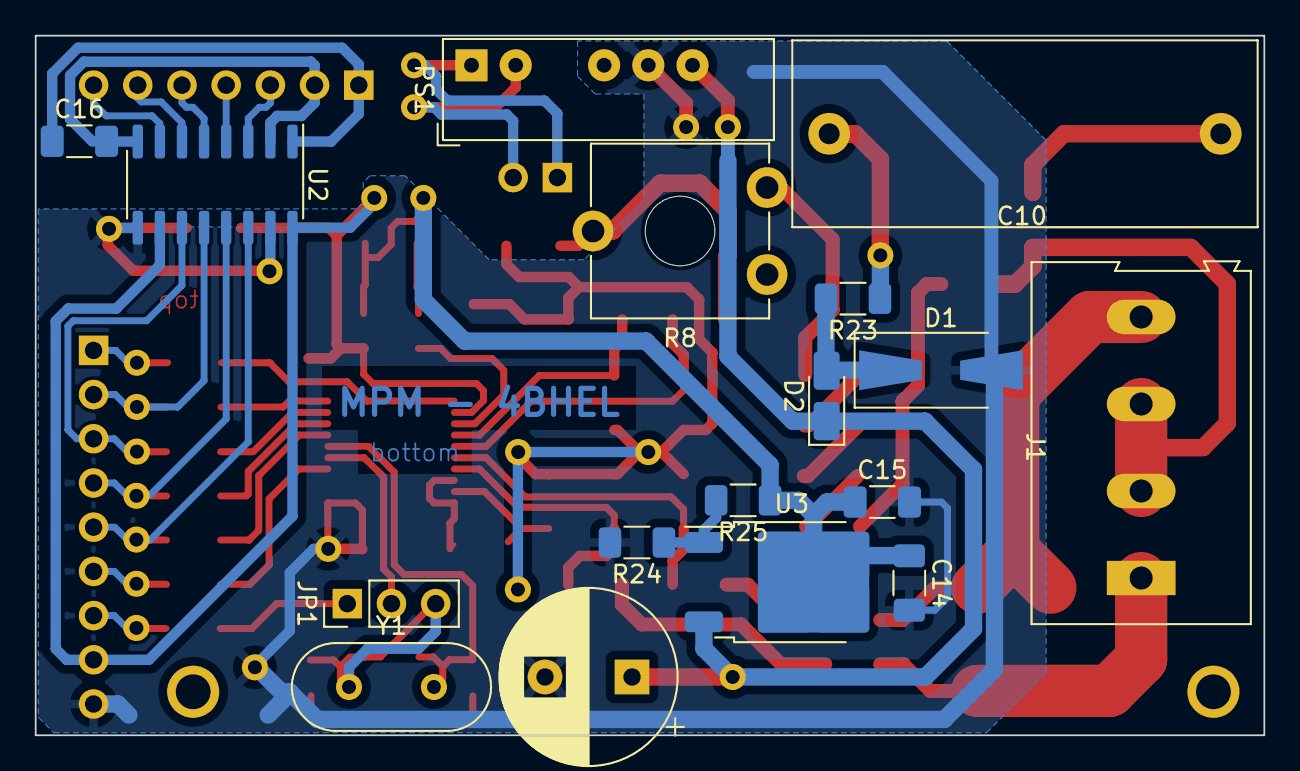
[picture p16: board breakout-board-power-measurement.kicad_pcb from below]

Board: 2 copper layers, 70.6 x 40.2 mm, 83 parts (17 on the bottom side), 53 nets.
