DominikRzecki/mpm-hardware/breakout-board-funk/funk_modul_fraesen/project/breakout-board-receiver.kicad_pcb

## KiCad design breakout-board-funk/funk_modul_fraesen/project/breakout-board-receiver.kicad_pcb (2023-03-14)

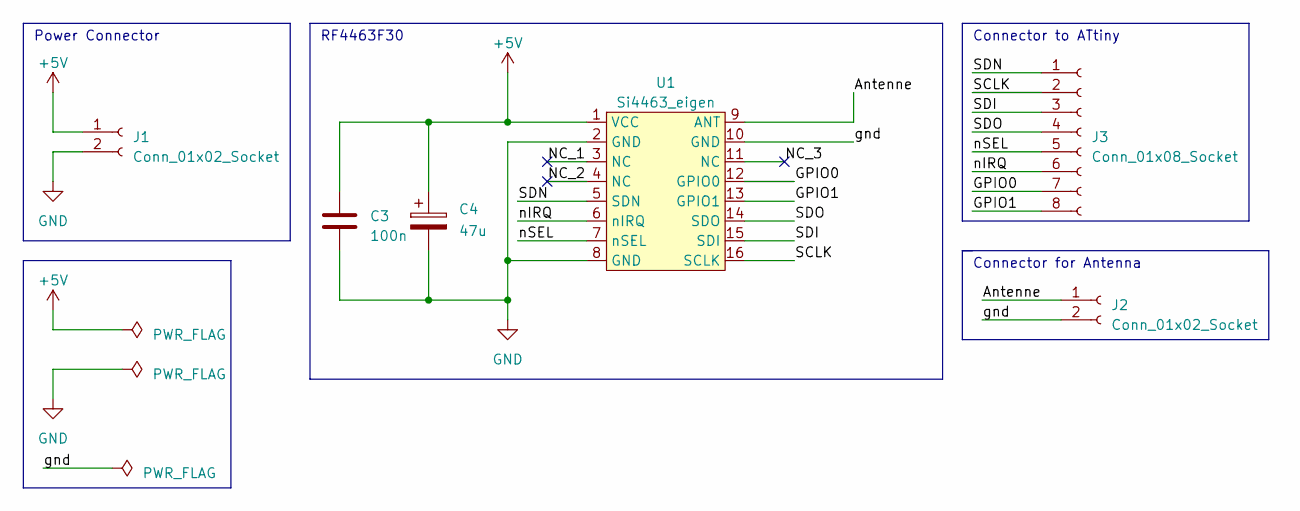
[picture p17: schematic breakout-board-receiver.kicad_sch]

Parts:
C3: 100n; C_1206_3216Metric_Pad1.33x1.80mm_HandSolder
C4: 47u; C_1206_3216Metric_Pad1.33x1.80mm_HandSolder
J1: Conn_01x02_Socket; PinSocket_1x02_P2.54mm_Vertical
J2: Conn_01x02_Socket; JST_EH_B2B-EH-A_1x02_P2.50mm_Vertical
J3: Conn_01x08_Socket; PinSocket_1x08_P2.54mm_Vertical
U1: Si4463_eigen; Si4463

Connections:
+5V: C3.1, C4.1, J1.1, U1.1 (VCC)
/Antenne: J2.1, U1.9 (ANT)
/GPIO0: J3.7, U1.12 (GPIO0)
/GPIO1: J3.8, U1.13 (GPIO1)
/NC_1: U1.3 (NC)
/NC_2: U1.4 (NC)
/NC_3: U1.11 (NC)
/SCLK: J3.2, U1.16 (SCLK)
/SDI: J3.3, U1.15 (SDI)
/SDN: J3.1, U1.5 (SDN)
/SDO: J3.4, U1.14 (SDO)
/gnd: J2.2, U1.10 (GND)
/nIRQ: J3.6, U1.6 (nIRQ)
/nSEL: J3.5, U1.7 (nSEL)
GND: C3.2, C4.2, J1.2, U1.2 (GND), U1.8 (GND)

Notes on the sheet:
RF4463F30
Power Connector
Connector to ATtiny
Connector for Antenna

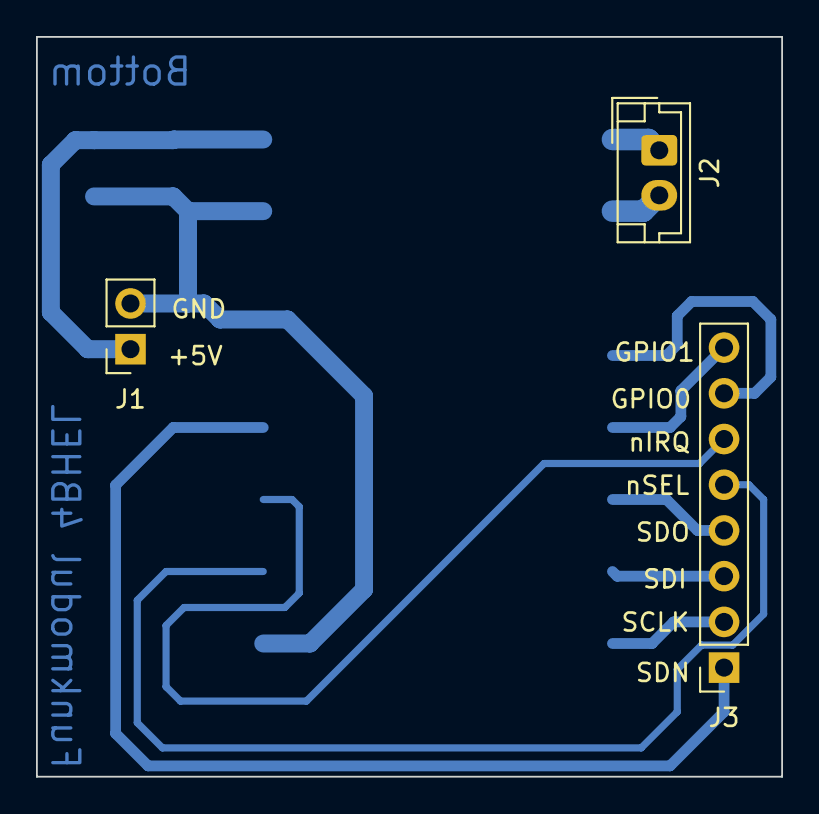
[picture p18: board breakout-board-receiver.kicad_pcb from above]

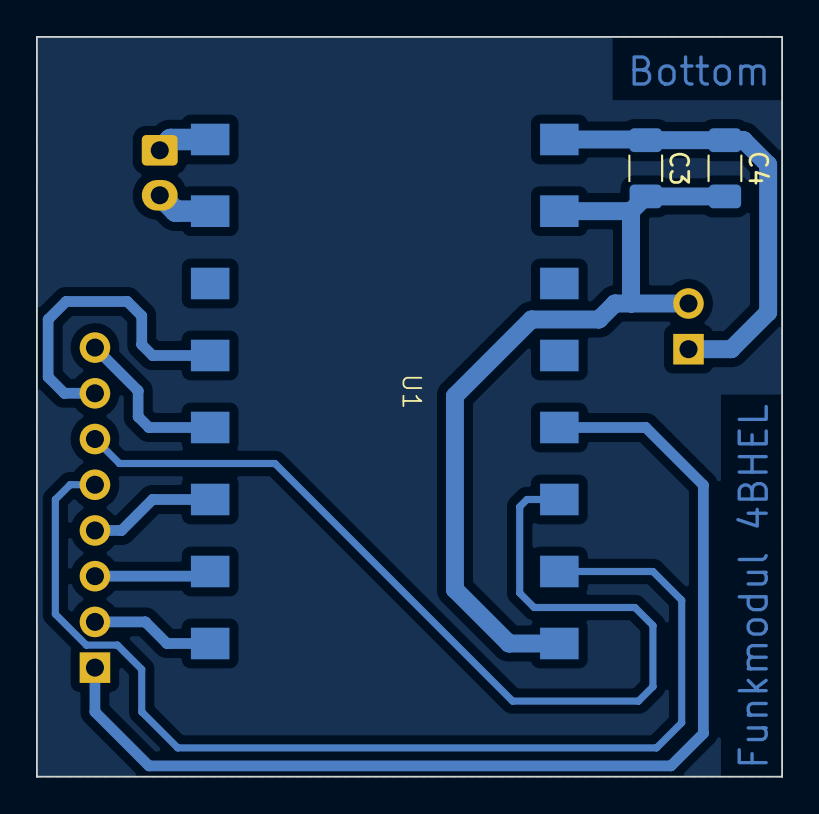
[picture p19: board breakout-board-receiver.kicad_pcb from below]

Board: 2 copper layers, 41.4 x 41.1 mm, 6 parts (3 on the bottom side), 12 nets.
