DominikRzecki/mpm-hardware/breakout-board-display-brain/breakout-board-display-brain/breakout-board-display-brain.kicad_pcb

## KiCad design breakout-board-display-brain/breakout-board-display-brain/breakout-board-display-brain.kicad_pcb (2023-03-14)

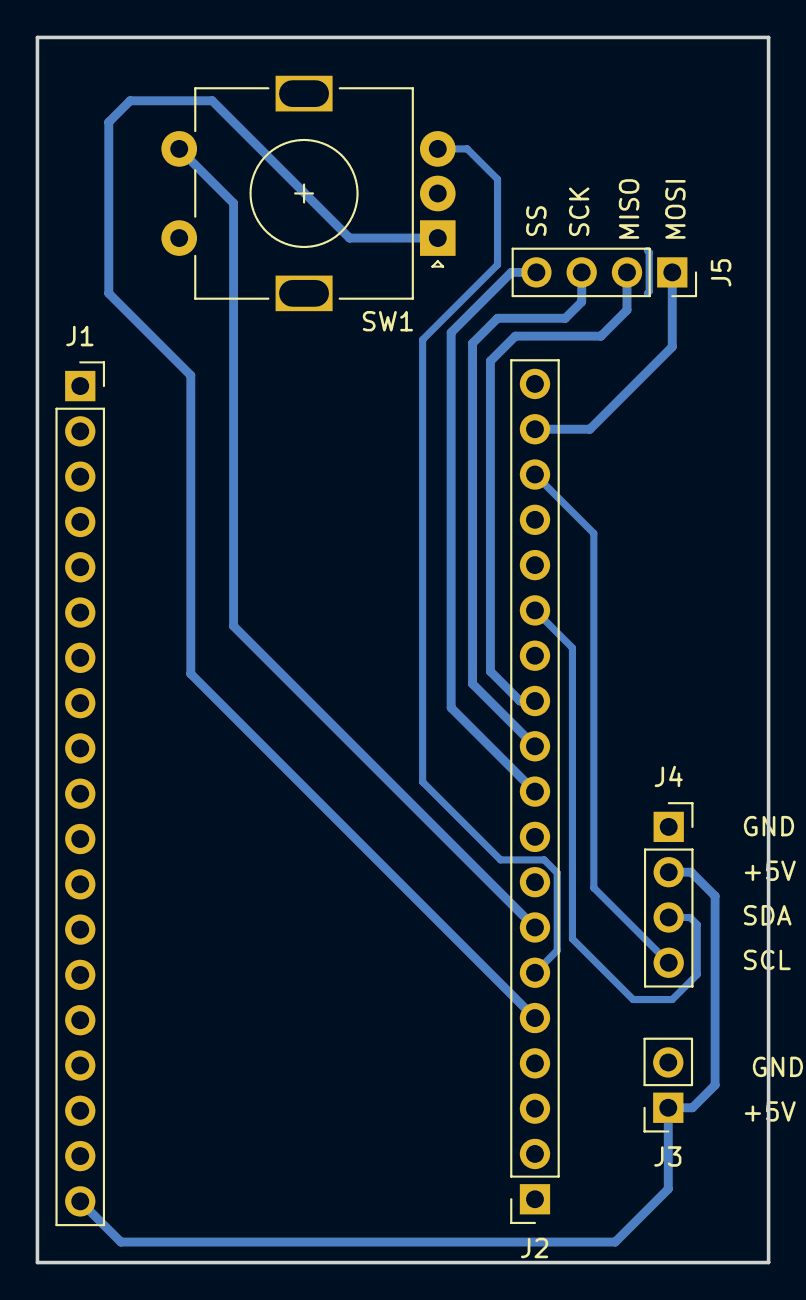
[picture p20: board breakout-board-display-brain.kicad_pcb from above]

Board: 2 copper layers, 41.0 x 68.7 mm, 6 parts (0 on the bottom side), 11 nets.

Parts:
J1, J2: Conn_01x19_Socket; PinSocket_1x19_P2.54mm_Vertical
J3: Conn_01x02_Socket; PinSocket_1x02_P2.54mm_Vertical
J4, J5: Conn_01x04_Socket; PinSocket_1x04_P2.54mm_Vertical
SW1: RotaryEncoder_Switch; RotaryEncoder_Alps_EC11E-Switch_Vertical_H20mm

Connections:
+5V: J1.19, J3.1, J4.2
/IO0: J2.6, SW1.B
/IO2: J2.5, SW1.A
/IO4: J2.7, SW1.S1
/IO5_SS: J2.10, J5.4
/IO18_SCK: J2.11, J5.3
/IO19_MISO: J2.12, J5.2
/IO21_SDA: J2.14, J4.3
/IO22_SCL: J2.17, J4.4
/IO23_MOSI: J2.18, J5.1
GND: J1.14, J2.13, J2.19, J3.2, J4.1, SW1.C, SW1.S2
