DominikRzecki/mpm-hardware/breakout-board-attiny/breakout-board-attiny.kicad_pcb

## KiCad design breakout-board-attiny/breakout-board-attiny.kicad_pcb (2023-03-05)

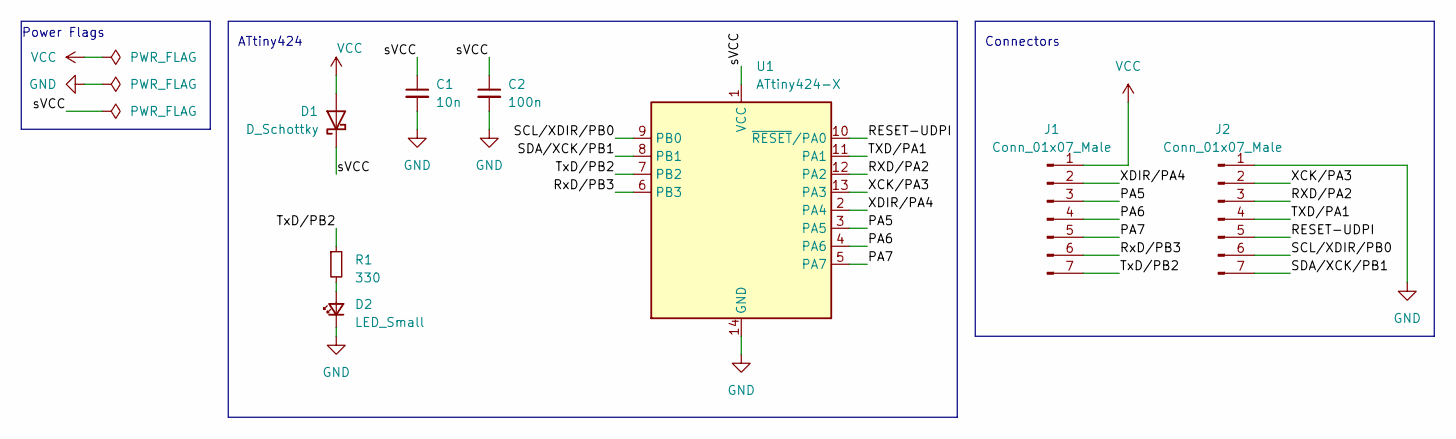
[picture p21: schematic breakout-board-attiny.kicad_sch, ATtiny TSSOP breakout board]

Parts:
C1: 10n; C_1206_3216Metric
C2: 100n; C_1206_3216Metric
D1: D_Schottky; D_1206_3216Metric
D2: LED_Small; D_1206_3216Metric
J1, J2: Conn_01x07_Male; PinSocket_1x07_P2.54mm_Vertical
R1: 330; R_1206_3216Metric
U1: ATtiny424-X; TSSOP-14_4.4x5mm_P0.65mm

Connections:
/PA5: J1.3, U1.3 (PA5)
/PA6: J1.4, U1.4 (PA6)
/PA7: J1.5, U1.5 (PA7)
/RESET-UDPI: J2.5, U1.10 (~RESET/PA0)
/RXD/PA2: J2.3, U1.12 (PA2)
/RxD/PB3: J1.6, U1.6 (PB3)
/SCL/XDIR/PB0: J2.6, U1.9 (PB0)
/SDA/XCK/PB1: J2.7, U1.8 (PB1)
/TXD/PA1: J2.4, U1.11 (PA1)
/TxD/PB2: J1.7, R1.1, U1.7 (PB2)
/XCK/PA3: J2.2, U1.13 (PA3)
/XDIR/PA4: J1.2, U1.2 (PA4)
/sVCC: C1.1, C2.1, D1.1 (K), U1.1 (VCC)
GND: C1.2, C2.2, D2.1 (K), J2.1, U1.14 (GND)
unnamed: D2.2 (A), R1.2
VCC: D1.2 (A), J1.1

Notes on the sheet:
Power Flags
Connectors
ATtiny424

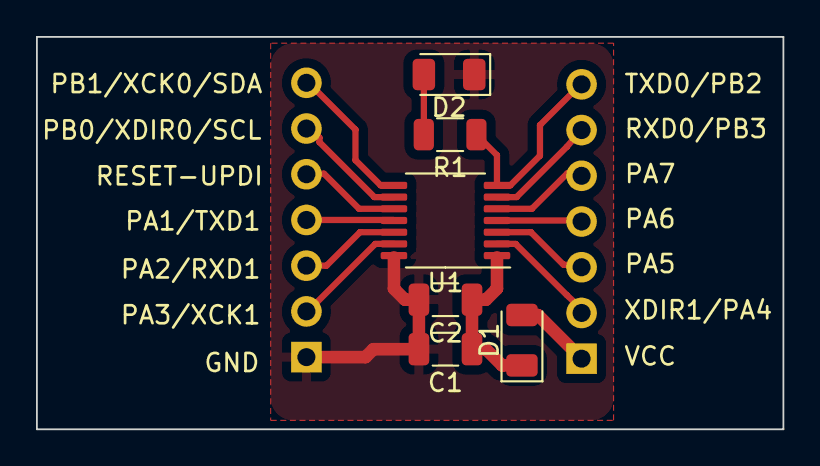
[picture p22: board breakout-board-attiny.kicad_pcb from above]

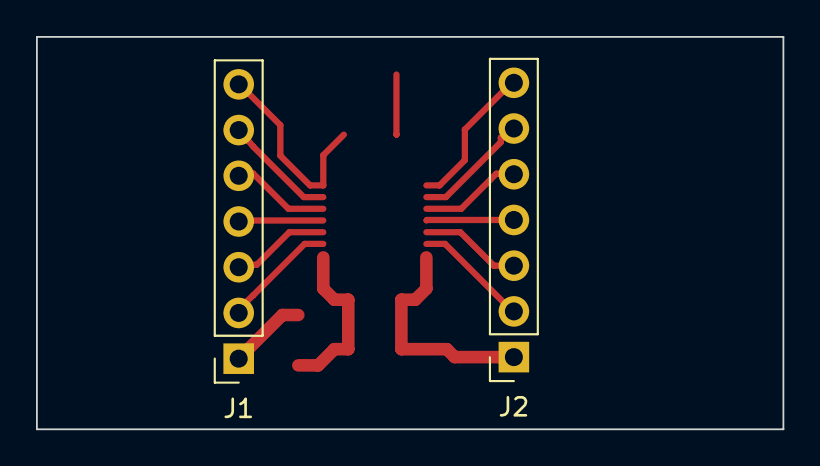
[picture p23: board breakout-board-attiny.kicad_pcb from below]

Board: 2 copper layers, 41.5 x 21.8 mm, 8 parts (2 on the bottom side), 16 nets.
