DominikRzecki/mpm-hardware/(commit log)

2023-02-01 Ich habe das und das verändert
2023-02-01 der Schaltplan für das module-brain-display Modul wurde zum GitHub Reposetory hinzugefügt
    [module-brain-display.kicad_pcb, module-brain-display.kicad_sch]
2023-02-01 Kicad Projektdateien für Epmfänger und Sender wurden von Laci hinzugefügt
    [module-receiver.kicad_pcb, module-receiver.kicad_sch, module-transmitter.kicad_pcb, module-transmitter.kicad_sch]
2023-02-01 der Schaltplan des attiny breakout boards wurde verschönert
    [breakout-board-attiny.kicad_sch]
2023-02-01 Added breakout for power measurement module on the high voltage side.
    [breakout-board-power-measurement.kicad_pcb, breakout-board-power-measurement.kicad_sch, module-power-measurement.kicad_pcb, module-power-measurement.kicad_sch]
2023-02-01 kicad datei für das powersupply breakout board wurde erstellt
    [breakout-board-powersupply.kicad_pcb, breakout-board-powersupply.kicad_sch]
2023-02-03 Das atTiny breajout board ist fertig!
    Laci hat einige Dinge an den breakout boards geändert
    [breakout-board-attiny.kicad_pcb, breakout-board-attiny.kicad_sch, breakout-board-power-measurement.kicad_sch, breakout-board-powersupply.kicad_pcb, breakout-board-powersupply.kicad_sch, breakout-board-schutz-trafo.kicad_pcb, breakout-board-schutz-trafo.kicad_sch]
2023-02-04 Schaltpläne und PCB-Layouts wurden erstellt
    allerdings noch nicht fertig gemacht
    [breakout-board-display-brain.kicad_pcb, breakout-board-display-brain.kicad_sch, breakout-board-receiver.kicad_pcb, breakout-board-receiver.kicad_sch, breakout-board-transmitter.kicad_pcb, breakout-board-transmitter.kicad_sch]
2023-02-12 Started work for the power measurement breakout board. Added shunt resitor and a voltage divider + few caps
    [breakout-board-power-measurement.kicad_sch]
2023-02-14 Revert "..."
    This reverts commit 6093de15b6a411821706cd1d809fe7ad2ca1dc62.
    [breakout-board-attiny.kicad_pcb, breakout-board-attiny.kicad_sch, breakout-board-display-brain.kicad_pcb, breakout-board-display-brain.kicad_sch, breakout-board-power-measurement.kicad_pcb, breakout-board-power-measurement.kicad_sch, breakout-board-powersupply.kicad_pcb, breakout-board-powersupply.kicad_sch]
2023-02-14 KiCad 7.0
    Updated to KiCad 7.0 file format
    [breakout-board-attiny.kicad_pcb, breakout-board-attiny.kicad_sch, breakout-board-display-brain.kicad_pcb, breakout-board-display-brain.kicad_sch, breakout-board-power-measurement.kicad_pcb, breakout-board-power-measurement.kicad_sch, breakout-board-powersupply.kicad_pcb, breakout-board-powersupply.kicad_sch]
2023-02-17 ATtiny breakout board done
    [breakout-board-attiny.kicad_pcb, breakout-board-attiny.kicad_sch]
2023-02-17 ATtiny breakout board finished and ready for production
    [breakout-board-attiny.kicad_pcb, breakout-board-attiny.kicad_sch]
2023-02-17 display brain breakout board changed
    [breakout-board-display-brain.kicad_sch, breakout-board-schutz-trafo.kicad_pcb, breakout-board-schutz-trafo.kicad_sch]
2023-02-17 Added power measurement README.md (docs)
2023-02-21 Amir approved: Rotary Encode Circuit
    [breakout-board-display-brain.kicad_sch]
2023-02-21 Update: nun approved!
    [breakout-board-display-brain.kicad_sch]
2023-02-21 further work on breakout board display brain
    [breakout-board-display-brain.kicad_pcb, breakout-board-display-brain.kicad_sch]
2023-02-21 connector added to display-brain breakout board
    [breakout-board-display-brain.kicad_pcb, breakout-board-display-brain.kicad_sch]
2023-02-21 updated power measurement circuit
    [breakout-board-power-measurement.kicad_sch]
2023-02-23 minor changes
    [breakout-board-power-measurement.kicad_sch]
2023-02-24 Major improvements: Power measurement schematic almost done.
    [breakout-board-power-measurement.kicad_sch]
2023-02-25 Added breakout board for simple X-Cap power supply.
    [breakout-board-power-measurement.kicad_sch, breakout-board-xcap-power-supply.kicad_pcb, breakout-board-xcap-power-supply.kicad_sch]
2023-02-28 plots generated for attiny breakout board
    [breakout-board-attiny-Edge_Cuts.gbr, breakout-board-attiny-F_Cu.gbr, breakout-board-attiny-NPTH.drl, breakout-board-attiny-PTH.drl, breakout-board-attiny-job.gbrjob]
2023-02-28 Safety circuit and x-cap psu circuit added.
    [breakout-board-power-measurement.kicad_sch]
2023-02-28 changes made to attiny and display brain breakout board
    [breakout-board-attiny.kicad_pcb, breakout-board-display-brain.kicad_sch]
2023-03-03 receiver and transmitter breakout board changed
    [breakout-board-receiver.kicad_sch, breakout-board-transmitter.kicad_sch]
2023-03-04 LTSpice .raw files wont be uploaded any more. power-measurement breakout will be finished tomorrow
    [breakout-board-power-measurement.kicad_sch]
2023-03-04 power measurement schematic organized
    [breakout-board-power-measurement.kicad_sch]
2023-03-04 display-brain modified
    [breakout-board-display-brain.kicad_sch]
2023-03-05 finsihed breakout-board.display-brain
    fertig fürs Fräsen
    [breakout-board-display-brain.kicad_pcb, breakout-board-display-brain.kicad_sch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]
2023-03-05 some footprints added
    [breakout-board-power-measurement.kicad_sch]
2023-03-06 Major updates: Power Measurement PCB-routing half way done.
    [breakout-board-power-measurement.kicad_sch]
2023-03-06 Added MCP3911 lib to project specific libraries
    [breakout-board-power-measurement.kicad_pcb, breakout-board-power-measurement.kicad_sch]
2023-03-07 Important updates and fine tunings to schematic
    [breakout-board-power-measurement.kicad_pcb, breakout-board-power-measurement.kicad_sch]
2023-03-09 Power measurement PCB 95% Done. Whats missing: proper cooil footprints, capacitive power supply net
    [breakout-board-power-measurement.kicad_pcb, breakout-board-power-measurement.kicad_sch]
2023-03-10 funk breakout board routed
    [breakout-board-display-brain.kicad_pcb, breakout-board-receiver.kicad_pcb, breakout-board-receiver.kicad_sch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]
2023-03-10 funk breakout board finished and sent out for manufacturing
    [breakout-board-receiver.kicad_pcb, breakout-board-receiver.kicad_sch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]
2023-03-12 Breakout Board: Power Measurement - status: done.. yaygit add -A!
    [breakout-board-power-measurement.kicad_pcb, breakout-board-power-measurement.kicad_sch]
2023-03-14 Revert "Merge branch 'main' of https://github.com/DominikRzecki/mpm-hardware"
    This reverts commit b1fb40005cc6000a652d43f250fbd6541baa0df3, reversing
    changes made to 77b873b98367f4cea487d2747d29dc0cf0db4d54.
    [breakout-board-display-brain.kicad_pcb, breakout-board-powersupply.kicad_pcb, breakout-board-powersupply.kicad_sch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]
2023-03-14 pcb backup restored
    [breakout-board-power-measurement.kicad_pcb]
2023-03-14 Restored old order
    [breakout-board-display-brain.kicad_pcb, breakout-board-powersupply.kicad_pcb, breakout-board-powersupply.kicad_sch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]
2023-03-14 plot files generated for manufacturing
    [breakout-board-display-brain.kicad_pcb, breakout-board-display-brain.kicad_sch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]
2023-03-14 Changed vias to test points
    [breakout-board-power-measurement.kicad_pcb, breakout-board-power-measurement.kicad_sch]
2023-03-14 entgültige boards zum fräsen geschickt
    [breakout-board-power-measurement.kicad_pcb, breakout-board-power-measurement.kicad_sch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]
2023-03-19 Fixed Power Measurement PCB, important changes.
    [breakout-board-power-measurement.kicad_pcb, breakout-board-power-measurement.kicad_sch]
2023-03-19 Minor Fixes.
    [breakout-board-power-measurement.kicad_pcb]
2023-03-19 Power measurement PCB plotted. Laci please check if the plot is correct.
    [breakout-board-power-measurement-B_Cu.gbr, breakout-board-power-measurement-Edge_Cuts.gbr, breakout-board-power-measurement-F_Cu.gbr, breakout-board-power-measurement-NPTH.drl, breakout-board-power-measurement-PTH.drl, breakout-board-power-measurement-job.gbrjob]
2023-03-19 power measurement fertig fürs fräsen
    [breakout-board-power-measurement-B_Cu.gbr, breakout-board-power-measurement-Edge_Cuts.gbr, breakout-board-power-measurement-F_Cu.gbr, breakout-board-power-measurement-NPTH-drl_map.gbr, breakout-board-power-measurement-NPTH.drl, breakout-board-power-measurement-PTH-drl_map.gbr, breakout-board-power-measurement-PTH.drl, breakout-board-power-measurement-job.gbrjob]
2023-03-28 neue ordner erstellt
    [ATtiny-final.kicad_pcb, ATtiny-final.kicad_sch, display-brain-final.kicad_pcb, display-brain-final.kicad_sch, funk-final.kicad_pcb, funk-final.kicad_sch, power-measurement-final.kicad_pcb, power-measurement-final.kicad_sch]
2023-03-31 display final finished
    [display-brain-final.kicad_pcb, display-brain-final.kicad_sch]
2023-03-31 funk-final finished
    [funk-final.kicad_pcb, funk-final.kicad_sch]
2023-03-31 funk finished
    [funk-final.kicad_pcb, funk-final.kicad_sch, funk-transmitter-final.kicad_pcb, funk-transmitter-final.kicad_sch]
2023-03-31 display brain platine fertig
    [display-brain-final.kicad_pcb, display-brain-final.kicad_sch]
2023-03-31 display brain platine erweitert
    [display-brain-final.kicad_pcb, display-brain-final.kicad_sch, funk-transmitter-final.kicad_pcb, funk-transmitter-final.kicad_sch]
2023-03-31 funk platine fertig gemacht
    [funk-final.kicad_pcb, funk-final.kicad_sch, funk-transmitter-final.kicad_pcb, funk-transmitter-final.kicad_sch]
2023-03-31 ATtiny platine fertig gestellt
    [ATtiny-final.kicad_pcb, ATtiny-final.kicad_sch]
2023-04-01 Increased width of power tracks from 0.2mm to 0.3mm
    [display-brain-final.kicad_pcb]
2023-04-01 5v versorgung für display geändert
    [display-brain-final.kicad_pcb, display-brain-final.kicad_sch]
2023-04-01 Replaced ASM1117 with LM317 in schematic.
    [display-brain-final.kicad_pcb, display-brain-final.kicad_sch]
2023-04-01 Updated PCB layout according to new schematic.(ASM1117-> LM317) (Beidl update)
    [breakout-board-display-brain.kicad_sch, breakout-board-power-measurement.kicad_sch, display-brain-final.kicad_pcb, display-brain-final.kicad_sch]
2023-04-11 display and funk changed
    [display-brain-final.kicad_pcb, display-brain-final.kicad_sch, funk-transmitter-final.kicad_pcb, funk-transmitter-final.kicad_sch]
2023-04-14 Fixed SPI
    [breakout-board-power-measurement.kicad_pcb, breakout-board-power-measurement.kicad_sch]
2023-04-14 Important fixes SDI/SDO swap, reset
    [breakout-board-power-measurement.kicad_sch]
2023-04-14 platinen angepasst
    [ATtiny-final-B_Cu.gbr, ATtiny-final-Edge_Cuts.gbr, ATtiny-final-F_Cu.gbr, ATtiny-final-In1_Cu.gbr, ATtiny-final-In2_Cu.gbr, ATtiny-final-NPTH.drl, ATtiny-final-PTH.drl, ATtiny-final-job.gbrjob]
2023-04-14 punkt bei pin 1 der ics hinzugefügt
    [ATtiny-final-B_Cu.gbr, ATtiny-final-Edge_Cuts.gbr, ATtiny-final-F_Cu.gbr, ATtiny-final-F_Silkscreen.gbr, ATtiny-final-In1_Cu.gbr, ATtiny-final-In2_Cu.gbr, ATtiny-final-NPTH.drl, ATtiny-final-PTH.drl]
2023-04-25 power measuremnt final started
    [funk-transmitter-final-B_Adhesive.gbr, funk-transmitter-final-B_Cu.gbr, funk-transmitter-final-B_Mask.gbr, funk-transmitter-final-B_Paste.gbr, funk-transmitter-final-B_Silkscreen.gbr, funk-transmitter-final-Edge_Cuts.gbr, funk-transmitter-final-F_Adhesive.gbr, funk-transmitter-final-F_Cu.gbr]
2023-04-28 power measurement final platine started
    [power-measurement-final.kicad_pcb, power-measurement-final.kicad_sch]
2023-04-28 power measuremnt final weitergemacht
    [power-measurement-final.kicad_pcb, power-measurement-final.kicad_sch]
2023-05-02 3D Druck V2/3
    [MPM_pwm v19.f3d, MPM_pwm v7.f3d, deckel_main_v2.stl, deckel_v2.stl, main_box_v2.stl, main_box_v3.stl]
2023-05-02 finales power measurement modul weitergemacht
    [power-measurement-final.kicad_pcb, power-measurement-final.kicad_sch]
2023-05-06 power measurement final almost completed
    [power-measurement-final.kicad_pcb, power-measurement-final.kicad_sch]
2023-05-06 small fixes
    [power-measurement-final.kicad_sch]
2023-05-08 Power measurement final almst ready
    [breakout-board-power-measurement.kicad_sch, breakout-power-supply.kicad_pcb, breakout-power-supply.kicad_sch, power-measurement-final.kicad_pcb, power-measurement-final.kicad_sch]
2023-05-08 various fixes
    [power-measurement-final.kicad_pcb, power-measurement-final.kicad_sch]
2023-05-08 Small changes
    [power-measurement-final.kicad_pcb, power-measurement-final.kicad_sch]
2023-05-09 SMPS routed
    [power-measurement-final.kicad_pcb, power-measurement-final.kicad_sch]
2023-05-09 power rmeasurement final finished
    [power-measurement-final.kicad_pcb, power-measurement-final.kicad_sch]
2023-05-12 funk plot
    [funk-transmitter-final-B_Adhesive.gbr, funk-transmitter-final-B_Cu.gbr, funk-transmitter-final-B_Mask.gbr, funk-transmitter-final-B_Paste.gbr, funk-transmitter-final-B_Silkscreen.gbr, funk-transmitter-final-Edge_Cuts.gbr, funk-transmitter-final-F_Adhesive.gbr, funk-transmitter-final-F_Cu.gbr]
2023-05-12 Updated power measurement
    [power-measurement-final.kicad_pcb, power-measurement-final.kicad_sch]
